BrennenJohnston/custom-braille-embosser-3d-printing-project/Documentation/_drafts/Reddit_Post_Copy.md

# Reddit Post - Custom Braille Embosser

> **Derived from:** [`Custom_Braille_Embosser_Publishing_Pack.md`](Custom_Braille_Embosser_Publishing_Pack.md). Edit the master pack first; re-derive this file.
> **Status:** This file mirrors the **most recent Reddit post copy** as written by the designer. Section B is the post body as intended for publishing.
> **Format:** Reddit self-post (a single Title field + a Markdown body). Paste the Title into the post title field and the Description into the post body. Good target subreddits include r/3Dprinting, r/functionalprint, r/Blind, and r/assistivetechnology (read each subreddit's self-promotion rules before posting).

---

## A. Title (paste into the Reddit post title field)

A surprisingly well functioning, fully 3D printed braille embosser for making custom braille business cards

---

## B. Description (paste into the Reddit post body)

I started this project last year because I wasn't able to find a quick, low cost way to make custom braille business cards. Custom business card braille embossers aren't easy to buy anymore, and the remaining options usually mean a slate and stylus, a Perkins style brailler, or a fully electric embosser (which is very expensive). Those tools all have their time and place, but none of them are simple or a cheap way to make a small batch of custom cards.

The device itself is pretty simple. It's fully 3D printed, hand operated, and snaps together from 10 parts with no fasteners, no springs, no glue, and no electronics. The braille message lives on a separate embossing cylinder paired with a matching counter cylinder. So, when the text changes, you only need to print a new embossing cylinder.

For the customizing part of the project, there is a browser based tool that handles the braille translation (powered by Liblouis) and generates both cylinder STLs for you. Your text and personal information never leaves your browser.

But if you just read that last sentence and said "NO THANK YOU!", that's completely fair. So there's also an OpenSCAD version included for anyone who prefers that workflow. The one tradeoff is that you'll need to grab your braille translation from a third party website and paste it into the OpenSCAD project yourself, which adds an extra step and is probably a steep learning curve if you haven't worked with OpenSCAD before.

The whole project is open source. My real hope is that others will develop this further than I'd ever have time to. There's lots of room for someone to refine the design or branch out into formats I never got around to, like full size pages, or different card sizes.

MakerWorld link: https://makerworld.com/en/models/2881581-custom-braille-card-embosser-hand-operated#profileId-3218374

Printables link: https://www.printables.com/model/1742352-custom-braille-embosser-a-hand-operated-3d-printab

Web-based braille customizer: https://braille-cylinder-stl-generator.vercel.app

I also made a 3 part video tutorial series covering the customizer, assembly, and usage if anyone wants to see it in action: https://youtu.be/77iXvJbkXh4?si=iJg1fes9QeOHQ45X

If you build one, I'd really appreciate a personal settings comment or review, so other makers know the design works on more printers. Thank you!
