BrennenJohnston/custom-braille-embosser-3d-printing-project/Photos/Custom Braille Embosser.png

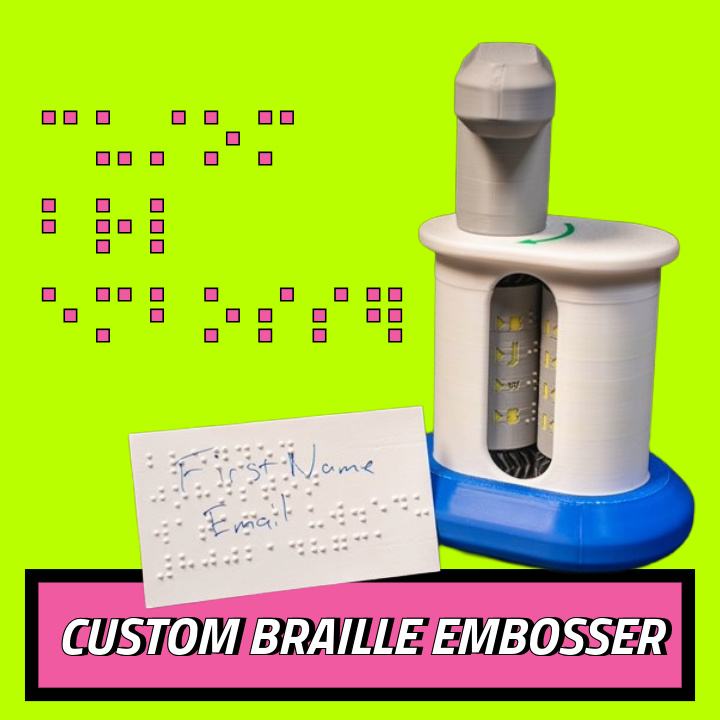
Photos/Custom Braille Embosser.png
