BrennenJohnston/custom-braille-embosser-3d-printing-project/Photos/DSC_8562.jpg

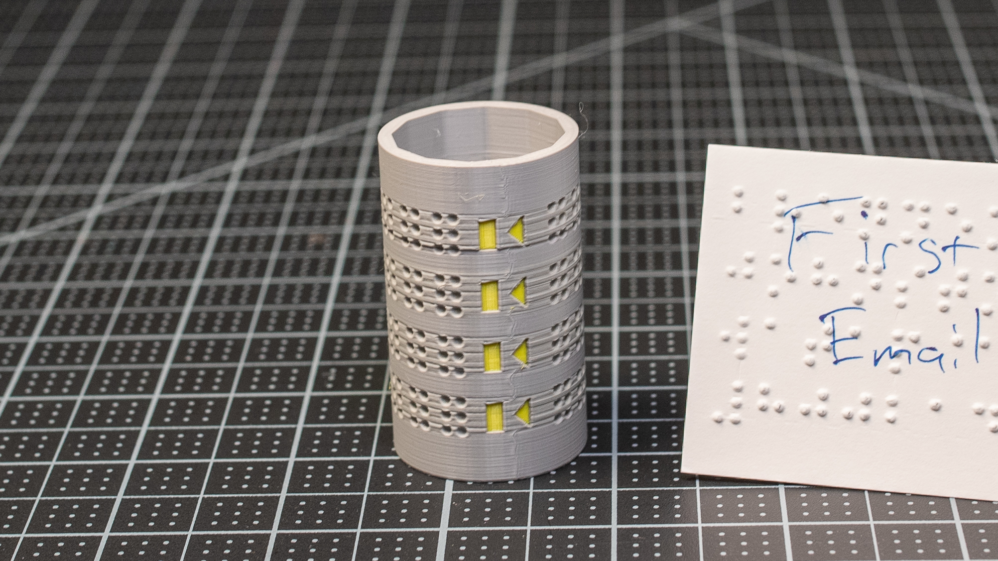
Photos/DSC_8562.jpg
