BrennenJohnston/custom-braille-embosser-3d-printing-project/Photos/DSC_8572.jpg

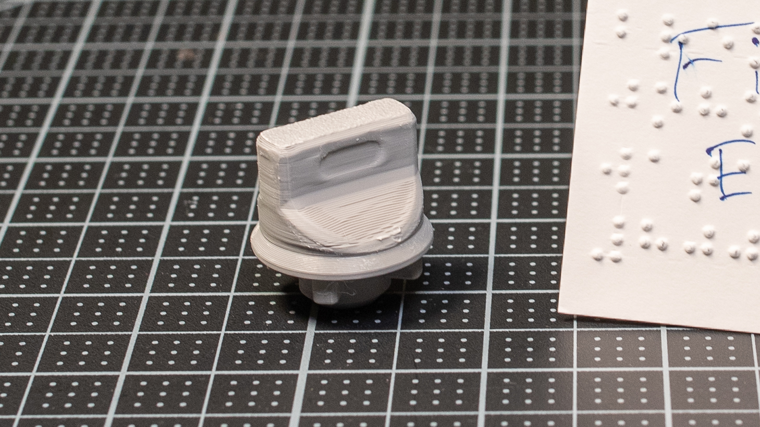
Photos/DSC_8572.jpg
