BrennenJohnston/custom-braille-embosser-3d-printing-project/Photos/DSC_8578.jpg

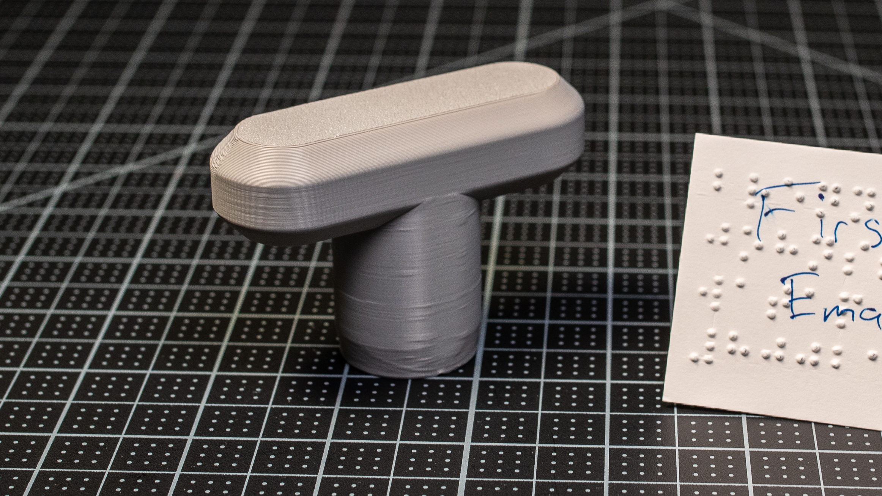
Photos/DSC_8578.jpg
