BrennenJohnston/custom-braille-embosser-3d-printing-project/Photos/DSC_8583.jpg

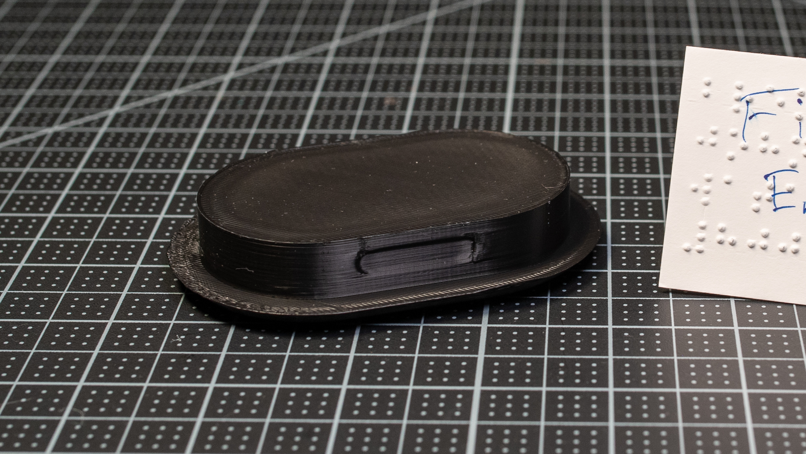
Photos/DSC_8583.jpg
