BrennenJohnston/custom-braille-embosser-3d-printing-project/Photos/DSC_8586-2.jpg

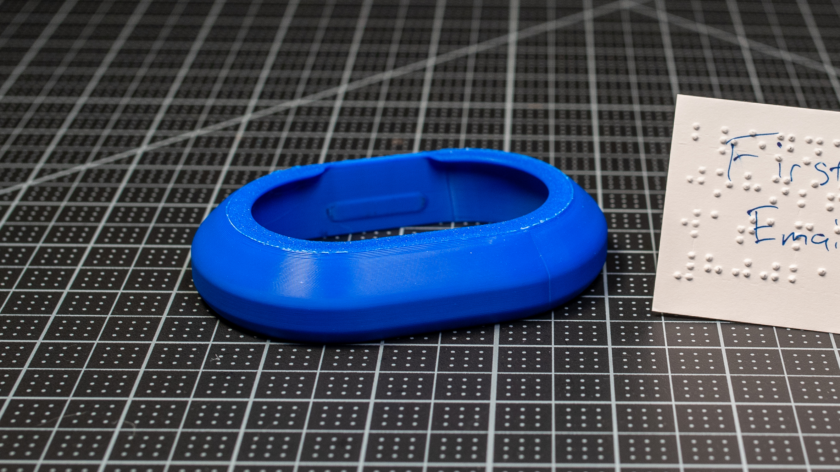
Photos/DSC_8586-2.jpg
