BrennenJohnston/custom-braille-embosser-3d-printing-project/Photos/Gif/Custom_Braille_Embosser_3d_Simulation.gif

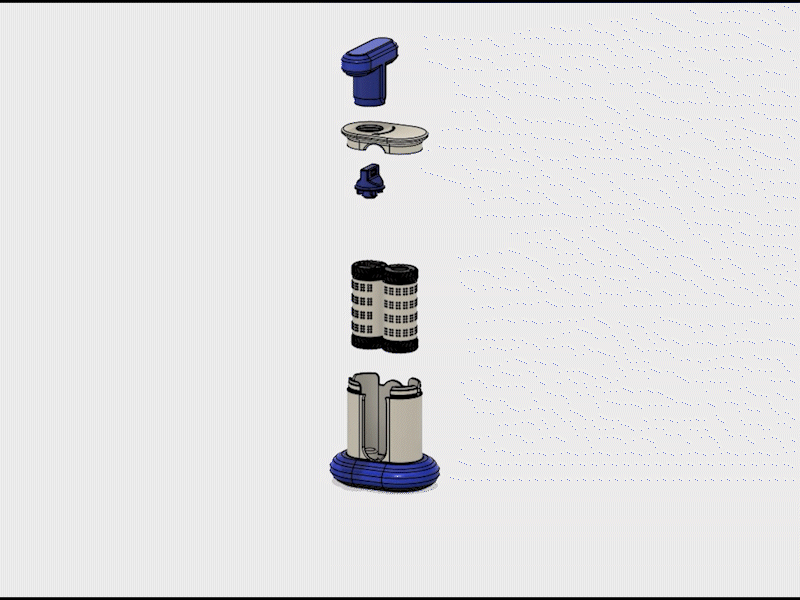
Photos/Gif/Custom_Braille_Embosser_3d_Simulation.gif
