BrennenJohnston/custom-braille-embosser-3d-printing-project/Settings Research/Cylinder High Quality profile/CHQP1.png

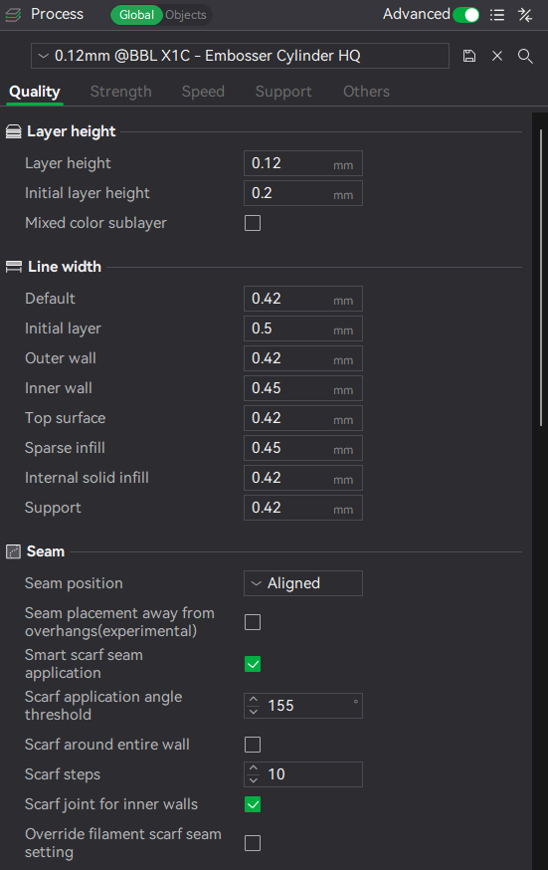
Settings Research/Cylinder High Quality profile/CHQP1.png
