BrennenJohnston/custom-braille-embosser-3d-printing-project/Settings Research/Cylinder High Quality profile/CHQP3.png

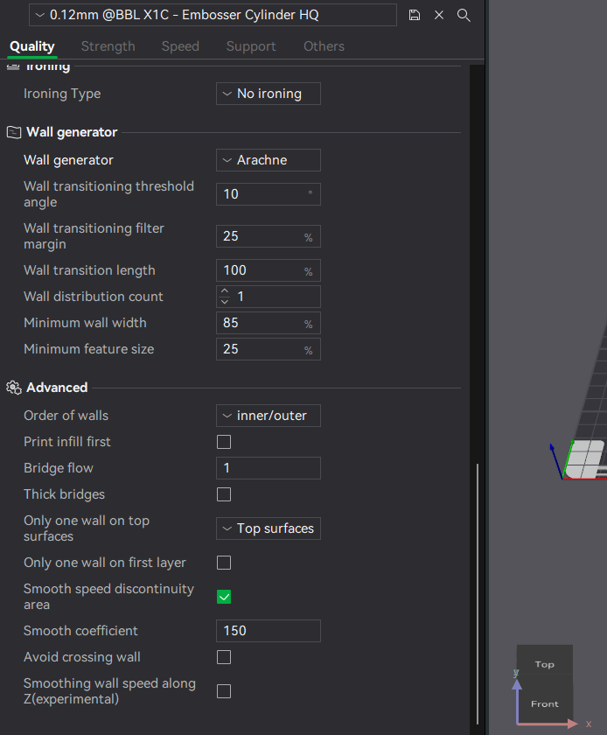
Settings Research/Cylinder High Quality profile/CHQP3.png
