BrennenJohnston/custom-braille-embosser-3d-printing-project/Settings Research/Cylinder High Quality profile/CHQP4.png

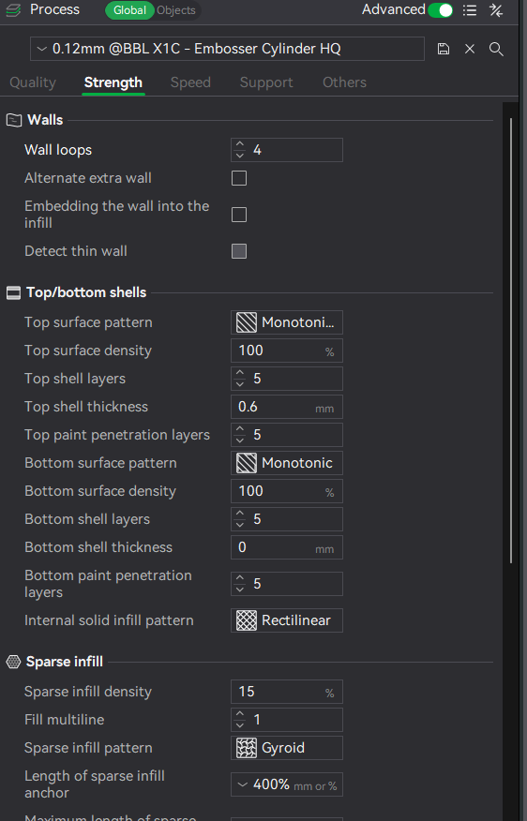
Settings Research/Cylinder High Quality profile/CHQP4.png
