BrennenJohnston/custom-braille-embosser-3d-printing-project/Settings Research/Cylinder High Quality profile/output.png

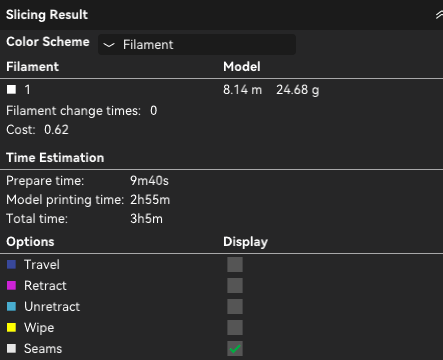
Settings Research/Cylinder High Quality profile/output.png
