BrennenJohnston/custom-braille-embosser-3d-printing-project/Build_Files/3D_Printing_Files/Print_Profiles/X1C/Braille Embosser Assembly and Custom Cylinders v1.0.3mf

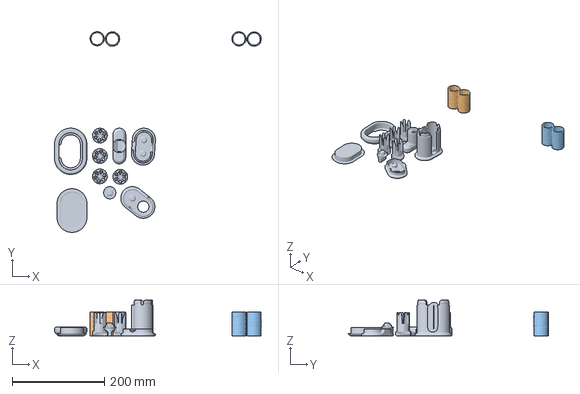
[picture p28: CAD file, 2026-07-27]
Build_Files/3D_Printing_Files/Print_Profiles/X1C/Braille Embosser Assembly and Custom Cylinders v1.0.3mf
448.9 x 435.4 x 77.6 mm
Assembly x 3
