BrennenJohnston/custom-braille-embosser-3d-printing-project/Build_Files/3D_Printing_Files/Print_Profiles/X1C/Braille Embosser Assembly v1.0 (0.2 Layer Height).3mf

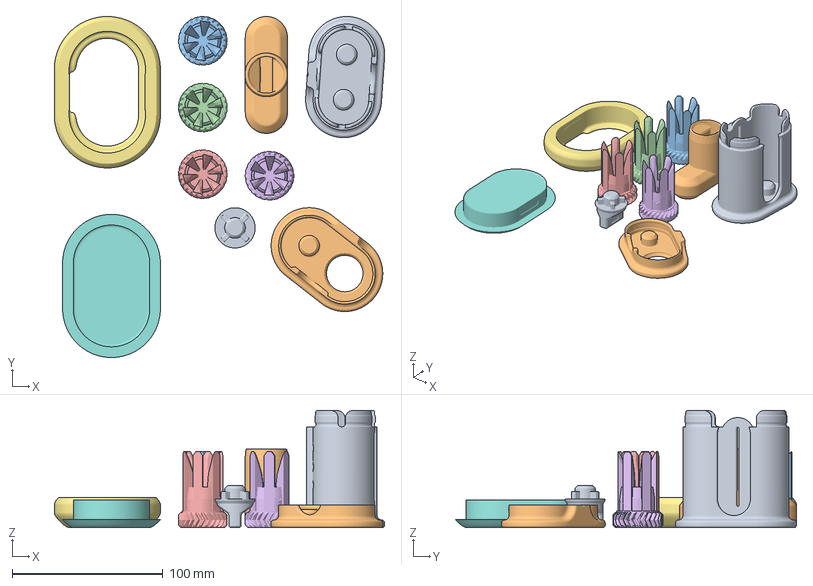
[picture p29: CAD file, 2026-07-27]
Build_Files/3D_Printing_Files/Print_Profiles/X1C/Braille Embosser Assembly v1.0 (0.2 Layer Height).3mf
219.0 x 226.0 x 77.6 mm
Base Body V6 (0.2) v12.stl
New Braille Roller Knob Handle V6 (0.2).stl
B2 v6 (0.2) v3.stl
B1 v6 (0.2) v3.stl
A2 v6 (0.2) v3.stl
A1 v6 (0.2) v3.stl
Braille Embosser Grip Bottom.stl
Braille Embosser Grip Top.stl
New Braille Roller Knob V6 (0.2).stl
Top Body V6 (0.2) v12.stl
