BrennenJohnston/custom-braille-embosser-3d-printing-project/Design_Files/CAD_Design_Files/STEP/P01-P10 - Braille Embosser Assembly v1.0.step

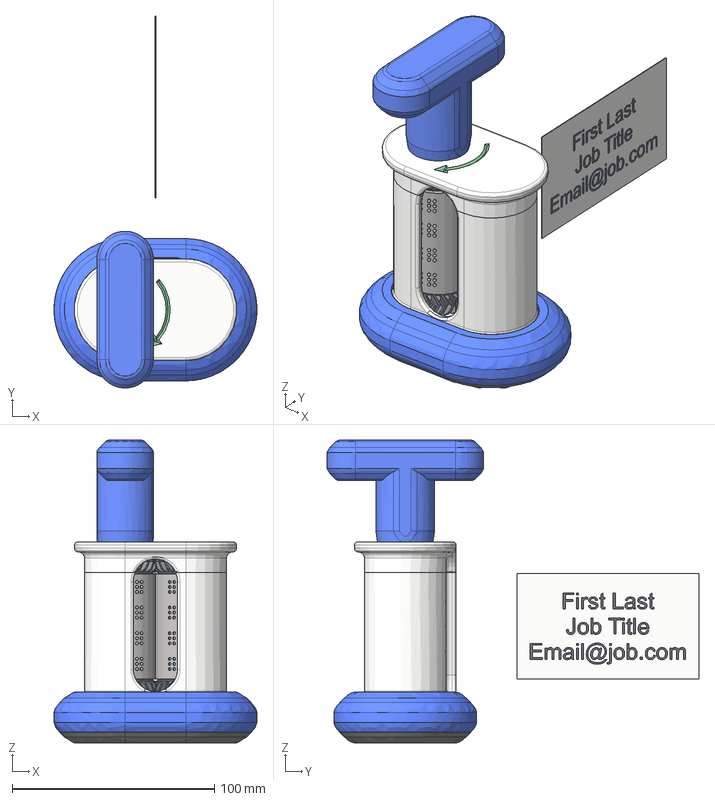
[picture p30: CAD file, 2026-07-27]
Design_Files/CAD_Design_Files/STEP/P01-P10 - Braille Embosser Assembly v1.0.step
100.3 x 183.8 x 149.6 mm
B2
B1
A2
A1
CP2
EP2
Top v6 (0.2)
Bottom v6 (0.2)
Knob
Handle
Bottom v6 (0.2)_1
Grip Top
Grip Bottom
Business Card Example
