BrennenJohnston/custom-braille-embosser-3d-printing-project/Build_Files/3D_Printing_Files/Embossing_Plates_Examples/Universal_Counter_Plate_0.3.stl

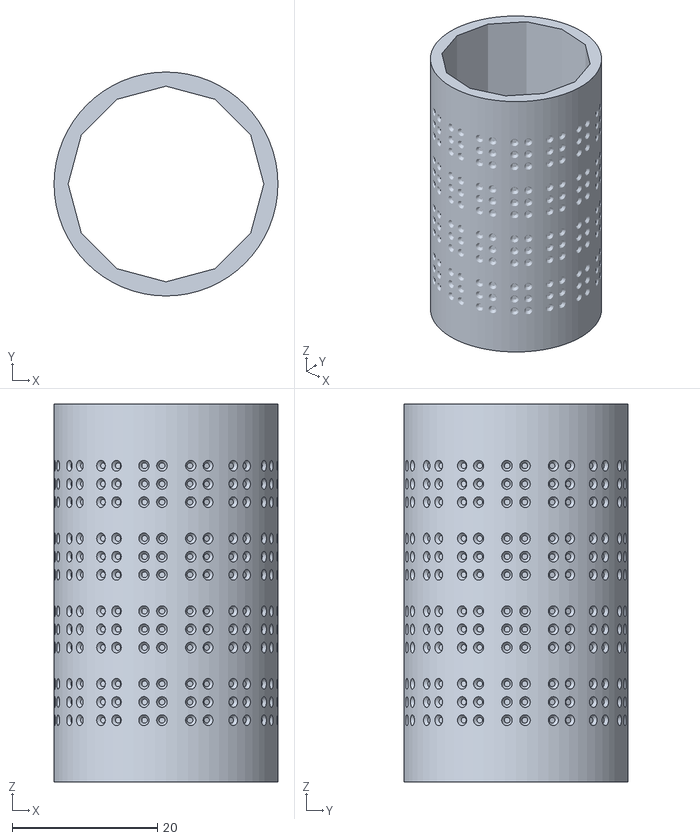
[picture p31: CAD file, 2026-07-27]
Build_Files/3D_Printing_Files/Embossing_Plates_Examples/Universal_Counter_Plate_0.3.stl
30.8 x 30.8 x 52.0
