BrennenJohnston/custom-braille-embosser-3d-printing-project/Build_Files/3D_Printing_Files/STL/P08 - Grip Extension Top v1.0 (0.2 Layer Height).stl

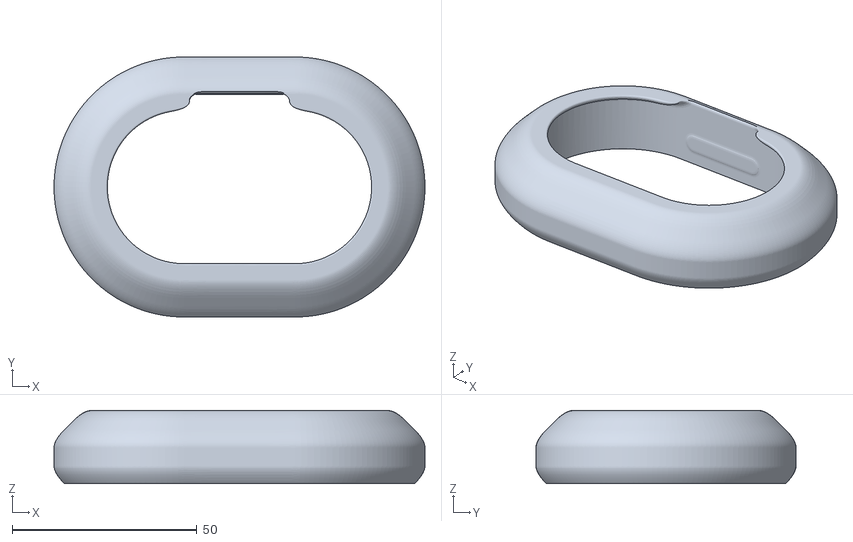
[picture p32: CAD file, 2026-07-27]
Build_Files/3D_Printing_Files/STL/P08 - Grip Extension Top v1.0 (0.2 Layer Height).stl
100.3 x 70.3 x 19.8
