BrennenJohnston/custom-braille-embosser-3d-printing-project/Design_Files/CAD_Design_Files/STEP/P09 Handle Connector + P10 Handle Grip - v1.0 (0.2 Layer Height).step

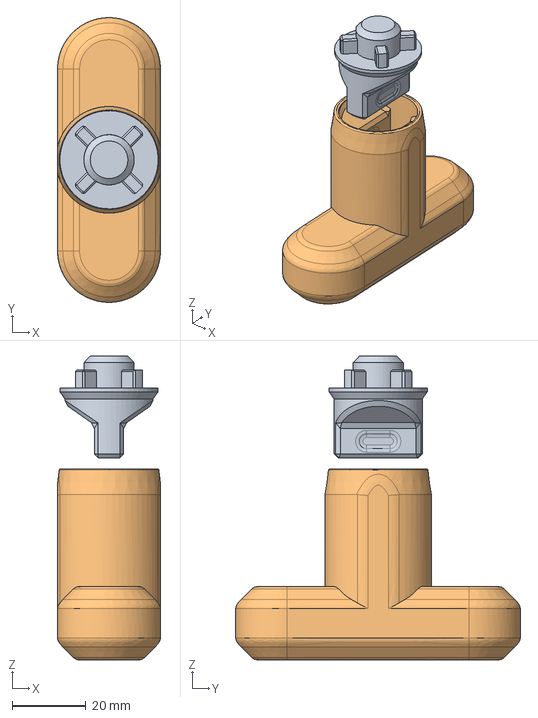
[picture p33: CAD file, 2026-07-27]
Design_Files/CAD_Design_Files/STEP/P09 Handle Connector + P10 Handle Grip - v1.0 (0.2 Layer Height).step
28.0 x 77.5 x 82.7 mm
Knob
Handle
