BrennenJohnston/custom-braille-embosser-3d-printing-project/Build_Files/3D_Printing_Files/Embossing_Plates_Examples/Embossing_Plate_Brennen_0.3.stl

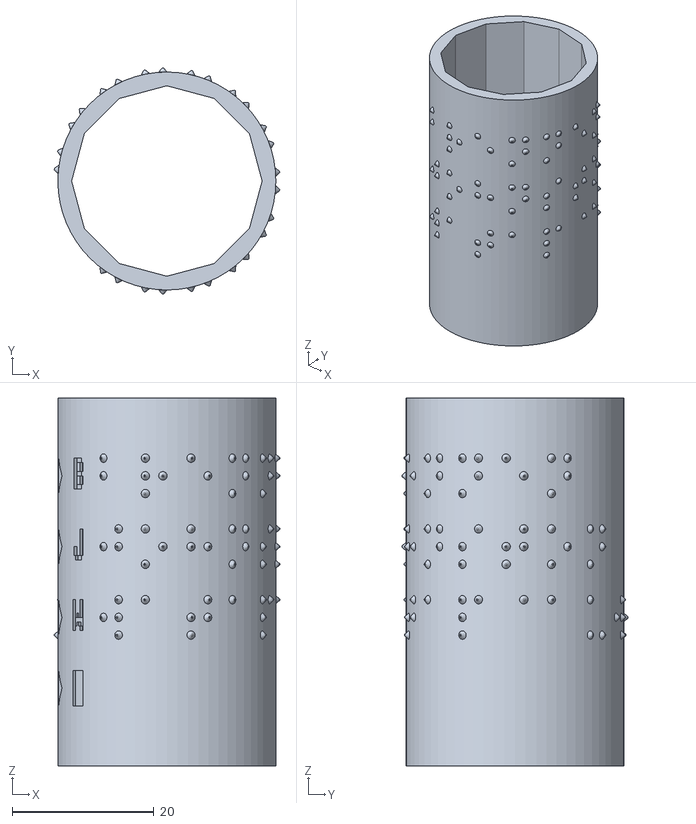
[picture p34: CAD file, 2026-07-27]
Build_Files/3D_Printing_Files/Embossing_Plates_Examples/Embossing_Plate_Brennen_0.3.stl
31.9 x 32.0 x 52.0
