BrennenJohnston/custom-braille-embosser-3d-printing-project/Build_Files/3D_Printing_Files/Print_Profiles/X1C/Embossing and Counter Cylinder High Quality.3mf

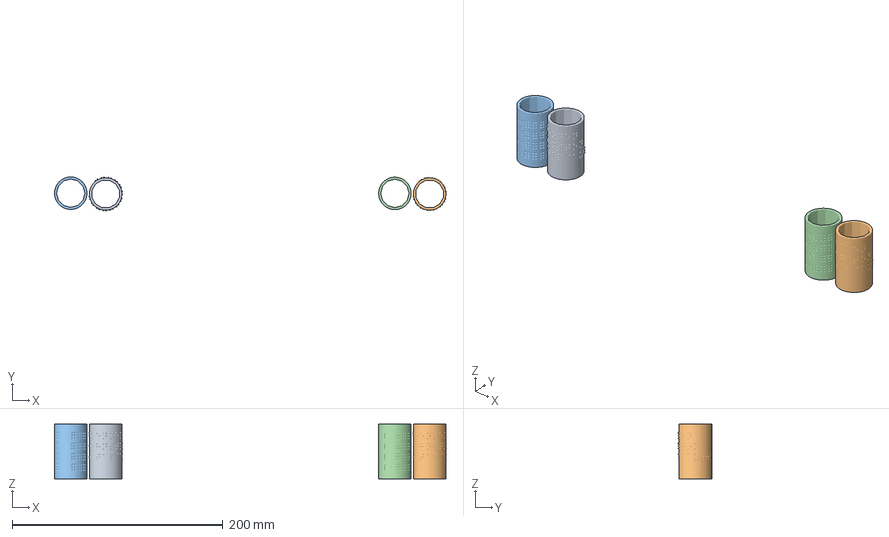
[picture p35: CAD file, 2026-07-27]
Build_Files/3D_Printing_Files/Print_Profiles/X1C/Embossing and Counter Cylinder High Quality.3mf
371.7 x 32.3 x 52.0 mm
Embossing_Plate_Brennen_0.4.stl
Embossing_Plate_Brennen_0.3.stl
Universal_Counter_Plate_0.4.stl
Universal_Counter_Plate_0.3.stl
