BrennenJohnston/custom-braille-embosser-3d-printing-project/Build_Files/3D_Printing_Files/STL/P01 - Body Base v1.0 (0.2 Layer Height).stl

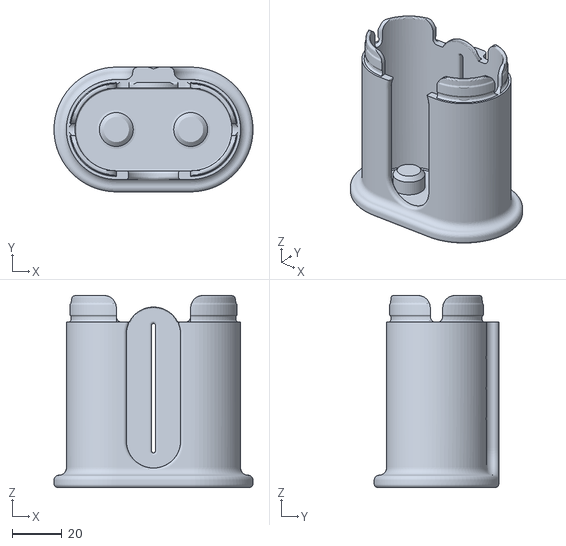
[picture p36: CAD file, 2026-07-27]
Build_Files/3D_Printing_Files/STL/P01 - Body Base v1.0 (0.2 Layer Height).stl
80.3 x 50.3 x 77.6
