BrennenJohnston/custom-braille-embosser-3d-printing-project/Design_Files/CAD_Design_Files/STEP/P03 Embosser Holder A1 + P04 Embosser Holder A2 + P05 Counter Holder B1 + P06 Counter Holder B2 - v1.0 (0.2 Layer Height).step

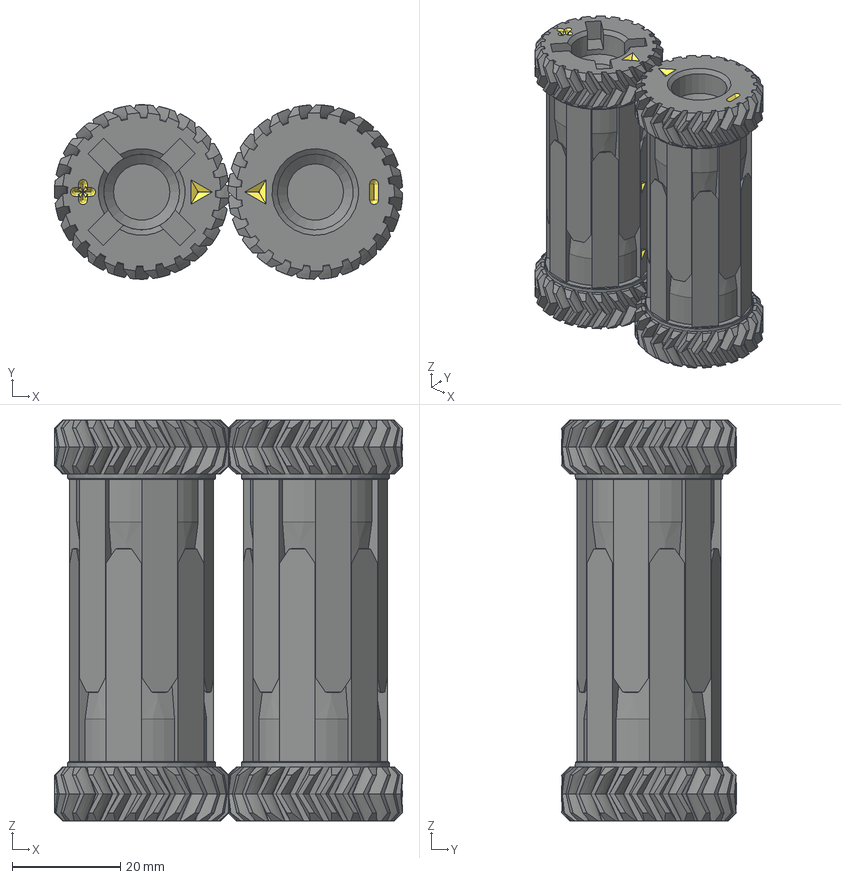
[picture p37: CAD file, 2026-07-27]
Design_Files/CAD_Design_Files/STEP/P03 Embosser Holder A1 + P04 Embosser Holder A2 + P05 Counter Holder B1 + P06 Counter Holder B2 - v1.0 (0.2 Layer Height).step
64.3 x 32.2 x 74.0 mm
B2
B1
A2
A1
