BrennenJohnston/custom-braille-embosser-3d-printing-project/Build_Files/3D_Printing_Files/STL/P02 - Body Top v1.0 (0.2 Layer Height).stl

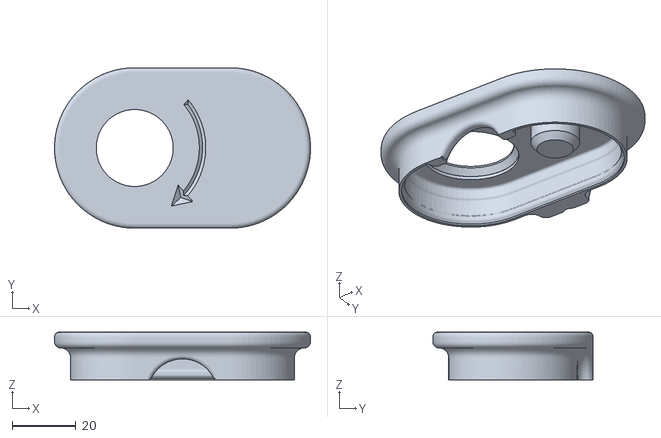
[picture p38: CAD file, 2026-07-27]
Build_Files/3D_Printing_Files/STL/P02 - Body Top v1.0 (0.2 Layer Height).stl
80.3 x 50.3 x 15.0
