BrennenJohnston/custom-braille-embosser-3d-printing-project/Design_Files/CAD_Design_Files/STEP/P07 Grip Extension Bottom + P08 Grip Extension Top - v1.0 (0.2 Layer Height).step

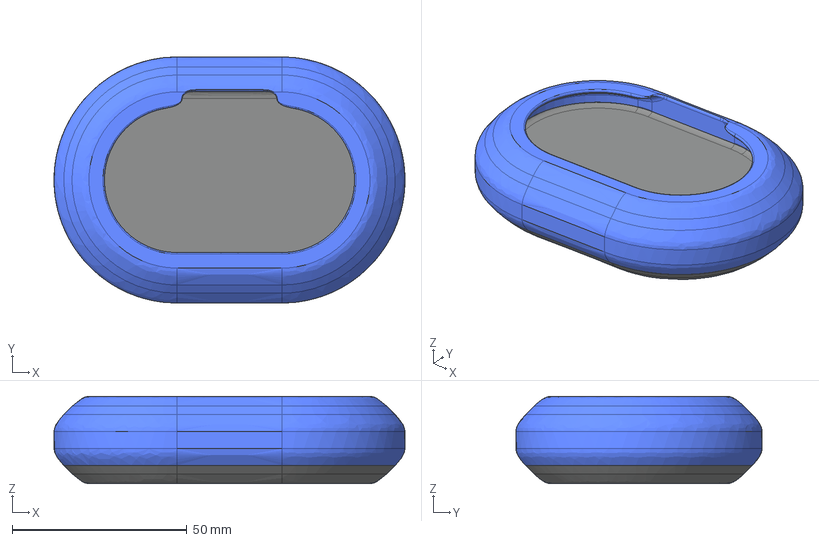
[picture p39: CAD file, 2026-07-27]
Design_Files/CAD_Design_Files/STEP/P07 Grip Extension Bottom + P08 Grip Extension Top - v1.0 (0.2 Layer Height).step
100.3 x 70.3 x 25.0 mm
Bottom v6 (0.2)
Grip Top
Grip Bottom
