BrennenJohnston/custom-braille-embosser-3d-printing-project/Design_Files/CAD_Design_Files/STEP/P01 Body Base + P02 Body Top - v1.0 (0.2 Layer Height).step

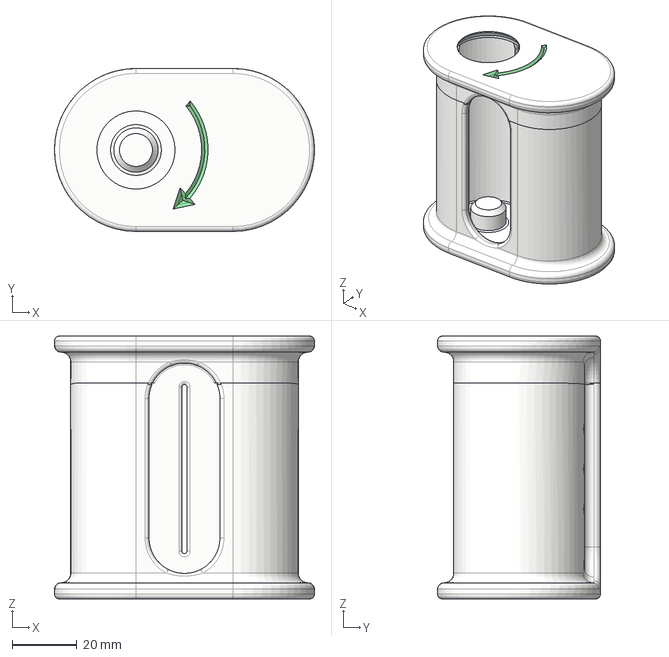
[picture p41: CAD file, 2026-07-27]
Design_Files/CAD_Design_Files/STEP/P01 Body Base + P02 Body Top - v1.0 (0.2 Layer Height).step
80.3 x 50.3 x 81.2 mm
Top v6 (0.2)
Bottom v6 (0.2)
