BrennenJohnston/custom-braille-embosser-3d-printing-project/Build_Files/3D_Printing_Files/STL/P09 - Handle Connector v1.0 (0.2 Layer Height).stl

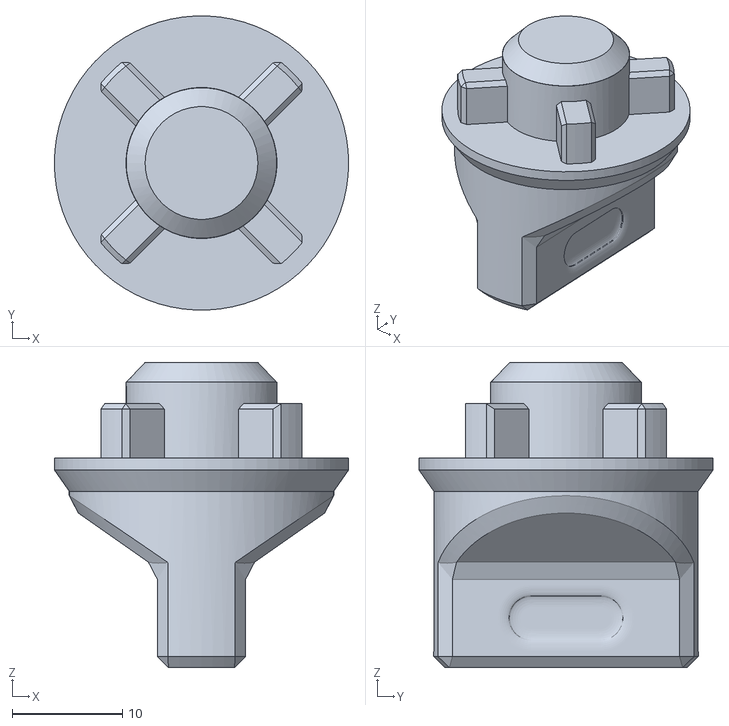
[picture p42: CAD file, 2026-07-27]
Build_Files/3D_Printing_Files/STL/P09 - Handle Connector v1.0 (0.2 Layer Height).stl
26.7 x 26.7 x 27.7
