BrennenJohnston/custom-braille-embosser-3d-printing-project/Build_Files/3D_Printing_Files/STL/P10 - Handle Grip v1.0 (0.2 Layer Height).stl

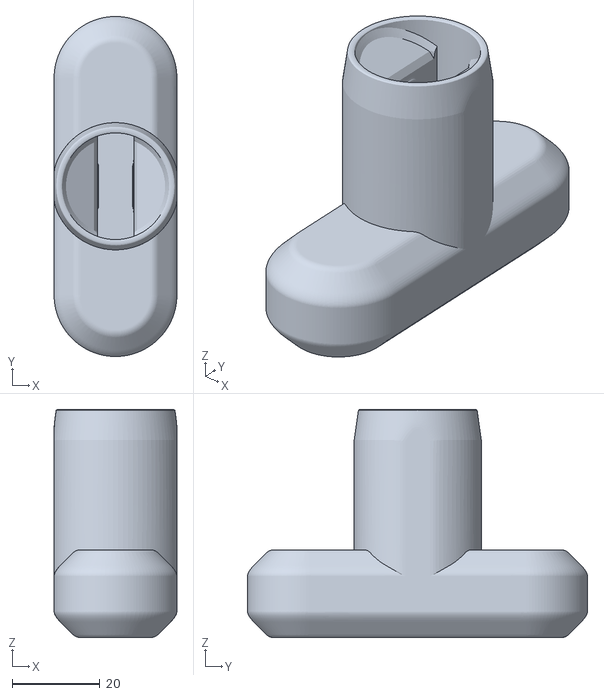
[picture p43: CAD file, 2026-07-27]
Build_Files/3D_Printing_Files/STL/P10 - Handle Grip v1.0 (0.2 Layer Height).stl
28.0 x 77.5 x 52.0
