BrennenJohnston/custom-braille-embosser-3d-printing-project/Build_Files/3D_Printing_Files/STL/P03 - Embosser Holder A1 v1.0 (0.2 Layer Height).stl

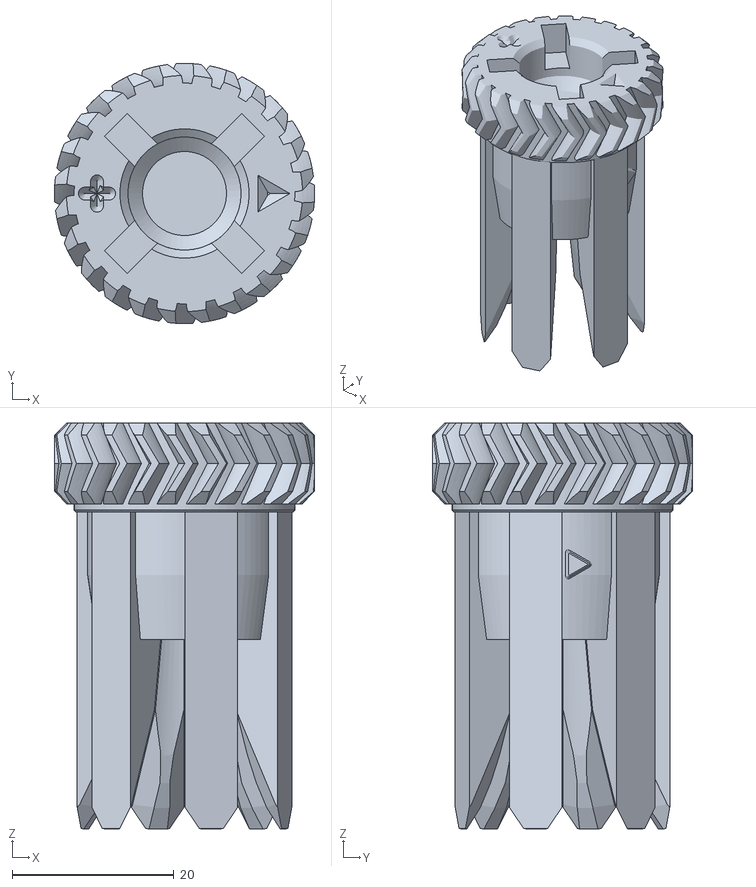
[picture p44: CAD file, 2026-07-27]
Build_Files/3D_Printing_Files/STL/P03 - Embosser Holder A1 v1.0 (0.2 Layer Height).stl
32.2 x 32.2 x 50.3
