BrennenJohnston/custom-braille-embosser-3d-printing-project/Build_Files/3D_Printing_Files/STL/P07 - Grip Extension Bottom v1.0 (0.2 Layer Height).stl

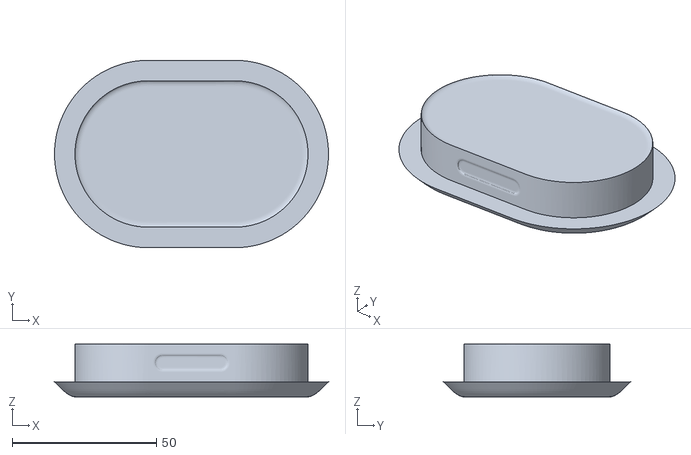
[picture p45: CAD file, 2026-07-27]
Build_Files/3D_Printing_Files/STL/P07 - Grip Extension Bottom v1.0 (0.2 Layer Height).stl
94.8 x 64.8 x 18.3
