BrennenJohnston/custom-braille-embosser-3d-printing-project/Build_Files/3D_Printing_Files/Embossing_Plates_Customizer/OpenSCAD_Offline_Alternative/Braille_Cylinder_STL_Generator.scad

// Braille Cylinder STL Generator (OpenSCAD)
// Generates embossing plates and counter plates for cylindrical objects
//
// =============================================================================
// WHAT THIS MAKES
// =============================================================================
//  • Cylinder Emboss Plate (Raised Dots) — dots on outer cylinder surface
//  • Cylinder Counter Plate (Hemispherical Recesses) — recesses on outer surface
//
// =============================================================================
// BEFORE YOU START
// =============================================================================
//  • Install OpenSCAD and open this .scad file
//  • In OpenSCAD, open View → Customizer to access all parameters
//  • This version requires pre-translated Unicode braille (no automatic translation)
//  • All parameters match the web-based generator UI for consistency
//
// =============================================================================
// TRANSLATE YOUR TEXT (REQUIRED) — BRANAH WORKFLOW
// =============================================================================
//  This OpenSCAD version does NOT include automatic translation. You must:
//  
//  1. Go to https://www.branah.com/braille-translator
//  2. In the options, select your desired braille grade:
//     - Grade 2 (contracted): Recommended for most uses
//     - Grade 1 (uncontracted): For names, emails, or when contractions cause confusion
//  3. Select Unicode Braille output (NOT ASCII Braille)
//  4. Type your English text in the left box
//  5. Copy the braille output (right box showing characters like ⠓⠑⠇⠇⠕)
//  6. In OpenSCAD's Customizer, paste into the Line_1, Line_2, etc. fields
//
//  IMPORTANT: If you paste ordinary English letters or see "INVALID CHARACTERS"
//  warning, re-translate on Branah and ensure Unicode Braille is selected.
//
// =============================================================================
// QUICK START GUIDE
// =============================================================================
//  1. Translate your text at https://www.branah.com/braille-translator
//  2. Paste pre-translated braille into Line_1, Line_2, etc.
//  3. Choose plate_type: Embossing Plate or Counter Plate
//  4. Choose dot_shape: Rounded or Cone (affects both plates)
//  5. Adjust dimensions in Expert Mode if needed
//  6. Render (F6) → File → Export → STL
//
// =============================================================================
// PARAMETER ORGANIZATION
// =============================================================================
//  Parameters are organized to match the web-based generator:
//
//  MAIN CONTROLS (always visible):
//  • Text Input - Pre-Translated Braille
//  • Plate Selection
//
//  EXPERT MODE (expandable submenus matching web UI):
//  • Expert Mode - Shape Selection (dot shapes, indicators)
//  • Expert Mode - Cylinder Dimensions
//  • Expert Mode - Braille Spacing (grid layout + positioning)
//  • Expert Mode - Braille Dot Adjustments (emboss/counter dimensions)
//
//  OPENSCAD-SPECIFIC:
//  • Rendering Quality
//
// =============================================================================
// REFERENCES
// =============================================================================
//  [1] Web-based Generator (with automatic translation): 
//      https://github.com/BrennenJohnston/braille-card-and-cylinder-stl-generator
//      https://braille-card-and-cylinder-stl-gener.vercel.app
//  [2] Branah Braille Translator: https://www.branah.com/braille-translator
//  [3] BANA — Size and Spacing: https://brailleauthority.org/size-and-spacing-braille-characters
//  [4] NLS — Specification 800: https://www.loc.gov/nls/
//  [5] 2010 ADA Standards: https://archive.ada.gov/
//
// =============================================================================
// ACKNOWLEDGMENTS
// =============================================================================
//  This OpenSCAD version is based on the web-based generator by Brennen Johnston.
//  Special thanks to Tobi Weinberg for the substantial time and effort volunteered
//  to help start the original project.
//
//  Original web app powered by Liblouis, an open-source professional braille
//  translator: https://liblouis.io/
// =============================================================================

/* [Text Input - Pre-Translated Braille] */
// Paste Unicode braille characters from https://www.branah.com/braille-translator
Line_1 = "⠓⠑⠇⠇⠕"; // First line of braille text
Line_2 = "⠺⠕⠗⠇⠙"; // Second line of braille text
Line_3 = ""; // Third line of braille text
Line_4 = ""; // Fourth line of braille text

/* [Plate Selection] */
// Choose which plate to generate
plate_type = "Embossing Plate"; // [Embossing Plate, Counter Plate]

/* [Paper Thickness Preset] */
// Preset optimized for paper thickness (sets multiple parameters below)
paper_thickness_preset = "0.4mm"; // [0.4mm, 0.3mm, Custom]

/* [Expert Mode - Shape Selection] */
// Braille Dot Shape (Emboss and Counter) - affects both plate types.
// PROJECT-LOCAL DEFAULT: "Cone" (upstream braille-stl-generator-openscad
// defaults to "Rounded"). Preserve this on re-vendor; see parent README
// "Project-local modifications" for rationale.
dot_shape = "Cone"; // [Rounded, Cone]
// Indicator Shapes (Emboss and Counter) - Row start/end markers
indicators = "On"; // [On, Off]

/* [Expert Mode - Cylinder Dimensions] */
cylinder_diameter_mm = 30.8; // [10:0.1:100] Cylinder outer diameter in mm
cylinder_height_mm = 52; // [20:1:150] Cylinder height in mm
polygon_cutout_radius_mm = 13.0; // [0:0.1:50] Polygonal cutout circumscribed radius (0 = no cutout)
polygon_cutout_points = 12; // [3:1:24] Number of sides/points for polygonal cutout
seam_offset_degrees = 0.0; // [0:1:360] Seam offset (degrees) — Rotates starting position around cylinder

/* [Expert Mode - Braille Spacing] */
// --- Braille Dimensions ---
grid_columns = 11; // [1:1:20] Number of braille cells per row available for text (2 cells reserved for indicators when On)
grid_rows = 4; // [1:1:10] Number of lines of braille
cell_spacing = 6.5; // [2:0.1:15] Horizontal spacing between cells (mm)
line_spacing = 10.0; // [5:0.1:25] Vertical spacing between lines (mm)
dot_spacing = 2.5; // [1:0.1:5] Spacing between dots within a cell (mm)

// --- Braille Positioning ---
// Note: on a cylinder, X = angular wrap around the seam — a linear "X adjust"
// has no useful meaning, so only the vertical adjust is exposed. Use
// `seam_offset_degrees` (Expert Mode - Cylinder Dimensions) to rotate the
// braille pattern around the cylinder axis.
braille_y_adjust = 0.0; // [-10:0.1:10] Vertical adjustment of braille pattern (mm)

/* [Expert Mode - Braille Dot Adjustments] */
// --- Embossing Braille Dot Dimensions (Rounded Shape) ---
rounded_dot_base_diameter = 1.5; // [0.5:0.1:3] Rounded dot base diameter (cone base) (mm)
rounded_dot_base_height = 0.5; // [0:0.1:2] Rounded dot base height (cone height) (mm)
rounded_dot_dome_diameter = 1.0; // [0.5:0.1:3] Rounded dome diameter (linked to cone flat top) (mm)
rounded_dot_dome_height = 0.5; // [0.1:0.1:2] Rounded dot dome height (mm)

// --- Embossing Braille Dot Dimensions (Cone Shape) ---
emboss_dot_base_diameter = 1.5; // [0.5:0.1:3] Cone dot base diameter (mm)
emboss_dot_height = 0.8; // [0.3:0.1:2] Cone dot height (mm)
emboss_dot_flat_hat = 0.4; // [0.1:0.1:2] Cone dot flat hat diameter (mm)

// --- Counter Braille Recessed Dot Dimensions (Rounded Shape / Bowl) ---
bowl_counter_dot_base_diameter = 1.8; // [0.5:0.1:5] Bowl recess base diameter (mm)
counter_dot_depth = 0.8; // [0.1:0.1:2] Bowl recess depth (mm)

// --- Counter Braille Recessed Dot Dimensions (Cone Shape) ---
cone_counter_dot_base_diameter = 1.9; // [0.5:0.1:3] Cone recess base diameter (mm)
cone_counter_dot_height = 0.7; // [0.3:0.1:2] Cone recess height (mm)
cone_counter_dot_flat_hat = 1.0; // [0.1:0.1:2] Cone recess flat hat diameter (mm)

/* [Rendering Quality] */
// Sphere quality for rounded shapes
render_quality = "Medium"; // [Low, Medium, High]
// Cone segments for cone shapes (8-32 range recommended)
cone_segments = 16; // [8:1:64] Number of segments for cone shapes

/* [Hidden] */
$fn = 32; // Resolution for curved surfaces

// Mathematical constants
PI = 3.14159265359;

// Preset value tables (PRESET_04, PRESET_03) and the preset_value() lookup
// helper live in presets.scad. Edit that file to change preset values.
include <presets.scad>;

// =============================================================================
// BACKWARD COMPATIBILITY - Test System Parameters
// =============================================================================
// The automated test system passes parameters via -D flags using these names.
// These hidden parameters allow the test system to work without modification.
//
// Usage: openscad -D 'combined_shape="rounded"' -D 'indicator_shapes="on"' ...
//
// IMPORTANT: keep this `/* [Hidden] */` marker so OpenSCAD's Customizer
// never renders these four vars as orphan, uncategorized sliders even if
// a new `/* [Section] */` heading gets inserted above this block later.
/* [Hidden] */
combined_shape = "";         // "rounded" or "cone" (from test system)
indicator_shapes = "";       // "on" or "off" (from test system)
hemisphere_quality = "";     // "low", "medium", "high" (from test system)
shape_type = "";             // "cylinder" (from test system, ignored - cylinder only)

// =============================================================================
// CALCULATED VALUES (Do not modify)
// =============================================================================

// Normalize dropdown selections to internal values
// Support both UI dropdowns (human-friendly) and test system parameters (lowercase)
is_emboss_plate = (plate_type == "positive") ? true :
                  (plate_type == "negative") ? false :
                  (plate_type == "Embossing Plate");

use_rounded_dots = (combined_shape == "rounded") ? true :
                   (combined_shape == "cone") ? false :
                   (dot_shape == "Rounded");

indicator_on = (indicator_shapes == "on") ? true :
               (indicator_shapes == "off") ? false :
               (indicators == "On");

// Map render quality to segment counts (support both UI and test system)
quality_fn = (hemisphere_quality == "low" || render_quality == "Low") ? 24 :
             (hemisphere_quality == "medium" || render_quality == "Medium") ? 32 :
             (hemisphere_quality == "high" || render_quality == "High") ? 64 : 32;

// =============================================================================
// PRESET ROUTING - Select preset vs. custom values
// =============================================================================
// Each `_preset_*` variable routes between the matching preset table entry
// (see presets.scad) and the user's slider value. If `paper_thickness_preset`
// is "0.4mm" or "0.3mm", the table value wins; otherwise the slider value
// (third argument) is used.

// Spacing parameters
_preset_grid_columns                   = preset_value(paper_thickness_preset, "grid_columns",                   grid_columns);
_preset_grid_rows                      = preset_value(paper_thickness_preset, "grid_rows",                      grid_rows);
_preset_cell_spacing                   = preset_value(paper_thickness_preset, "cell_spacing",                   cell_spacing);
_preset_line_spacing                   = preset_value(paper_thickness_preset, "line_spacing",                   line_spacing);
_preset_dot_spacing                    = preset_value(paper_thickness_preset, "dot_spacing",                    dot_spacing);
_preset_braille_y_adjust               = preset_value(paper_thickness_preset, "braille_y_adjust",               braille_y_adjust);

// Emboss Rounded parameters
_preset_rounded_dot_base_diameter      = preset_value(paper_thickness_preset, "rounded_dot_base_diameter",      rounded_dot_base_diameter);
_preset_rounded_dot_base_height        = preset_value(paper_thickness_preset, "rounded_dot_base_height",        rounded_dot_base_height);
_preset_rounded_dot_dome_diameter      = preset_value(paper_thickness_preset, "rounded_dot_dome_diameter",      rounded_dot_dome_diameter);
_preset_rounded_dot_dome_height        = preset_value(paper_thickness_preset, "rounded_dot_dome_height",        rounded_dot_dome_height);

// Emboss Cone parameters
_preset_emboss_dot_base_diameter       = preset_value(paper_thickness_preset, "emboss_dot_base_diameter",       emboss_dot_base_diameter);
_preset_emboss_dot_height              = preset_value(paper_thickness_preset, "emboss_dot_height",              emboss_dot_height);
_preset_emboss_dot_flat_hat            = preset_value(paper_thickness_preset, "emboss_dot_flat_hat",            emboss_dot_flat_hat);

// Counter Bowl parameters
_preset_bowl_counter_dot_base_diameter = preset_value(paper_thickness_preset, "bowl_counter_dot_base_diameter", bowl_counter_dot_base_diameter);
_preset_counter_dot_depth              = preset_value(paper_thickness_preset, "counter_dot_depth",              counter_dot_depth);

// Counter Cone parameters
_preset_cone_counter_dot_base_diameter = preset_value(paper_thickness_preset, "cone_counter_dot_base_diameter", cone_counter_dot_base_diameter);
_preset_cone_counter_dot_height        = preset_value(paper_thickness_preset, "cone_counter_dot_height",        cone_counter_dot_height);
_preset_cone_counter_dot_flat_hat      = preset_value(paper_thickness_preset, "cone_counter_dot_flat_hat",      cone_counter_dot_flat_hat);

// Cylinder parameters
_preset_cylinder_diameter_mm           = preset_value(paper_thickness_preset, "cylinder_diameter_mm",           cylinder_diameter_mm);
_preset_cylinder_height_mm             = preset_value(paper_thickness_preset, "cylinder_height_mm",             cylinder_height_mm);
_preset_polygon_cutout_radius_mm       = preset_value(paper_thickness_preset, "polygon_cutout_radius_mm",       polygon_cutout_radius_mm);
_preset_polygon_cutout_points          = preset_value(paper_thickness_preset, "polygon_cutout_points",          polygon_cutout_points);
_preset_seam_offset_degrees            = preset_value(paper_thickness_preset, "seam_offset_degrees",            seam_offset_degrees);

// =============================================================================
// ACTIVE PARAMETERS - Final values used by geometry
// =============================================================================
// These variables provide the final parameter values used by the geometry code.
// They incorporate both preset routing (above) and shape-based routing (rounded vs cone).

// Active emboss dot parameters (based on shape selection, using preset-routed values)
// Note: cone/rounded emboss modules consume the underlying _preset_* constants
// directly; only the composite height is needed at this layer.
active_emboss_height = use_rounded_dots ? (_preset_rounded_dot_base_height + _preset_rounded_dot_dome_height) : _preset_emboss_dot_height;

// Active counter dot parameters (based on shape selection, using preset-routed values)
active_counter_base_diameter = use_rounded_dots ? _preset_bowl_counter_dot_base_diameter : _preset_cone_counter_dot_base_diameter;
active_counter_height = use_rounded_dots ? _preset_counter_dot_depth : _preset_cone_counter_dot_height;

// Active spacing parameters (pass through from preset routing)
active_grid_columns = _preset_grid_columns;
active_grid_rows = _preset_grid_rows;
active_cell_spacing = _preset_cell_spacing;
active_line_spacing = _preset_line_spacing;
active_dot_spacing = _preset_dot_spacing;
active_braille_y_adjust = _preset_braille_y_adjust;

// Active cylinder parameters (pass through from preset routing)
active_cylinder_diameter_mm = _preset_cylinder_diameter_mm;
active_cylinder_height_mm = _preset_cylinder_height_mm;
active_polygon_cutout_radius_mm = _preset_polygon_cutout_radius_mm;
active_polygon_cutout_points = _preset_polygon_cutout_points;
active_seam_offset_degrees = _preset_seam_offset_degrees;

// Grid dimensions (accounting for indicator shapes if enabled)
actual_grid_columns = indicator_on ? (active_grid_columns + 2) : active_grid_columns;
grid_width = (actual_grid_columns - 1) * active_cell_spacing;
grid_height = (active_grid_rows - 1) * active_line_spacing;
top_margin = (active_cylinder_height_mm - grid_height) / 2;

// Cylinder grid geometry — shared by cylinder_emboss_plate and
// cylinder_counter_plate. Both modules used to recompute these identically
// inline; hoisting them keeps the two plates in lockstep so any spacing
// change automatically applies to both. Names mirror the prior local names
// so the module bodies need no changes beyond removing the duplicates.
radius                = active_cylinder_diameter_mm / 2;
grid_angle            = grid_width / radius;
start_angle           = -grid_angle / 2;
cell_spacing_angle    = active_cell_spacing / radius;
dot_spacing_angle     = active_dot_spacing / radius;
dot_col_angle_offsets = [-dot_spacing_angle / 2, dot_spacing_angle / 2];
dot_row_offsets       = [active_dot_spacing, 0, -active_dot_spacing];
dot_positions         = [[0, 0], [1, 0], [2, 0], [0, 1], [1, 1], [2, 1]];

// Counter plate recess radii (spherical cap formula to match web generator)
// For a bowl recess: R = (a² + h²) / (2h) where a = opening radius, h = depth
// This ensures the opening diameter = bowl_counter_dot_base_diameter and depth = counter_dot_depth
_bowl_a = _preset_bowl_counter_dot_base_diameter / 2;
_bowl_h = _preset_counter_dot_depth;
bowl_recess_radius = (_bowl_a * _bowl_a + _bowl_h * _bowl_h) / (2 * _bowl_h);
bowl_center_offset = bowl_recess_radius - _bowl_h;

// =============================================================================
// HELPER FUNCTIONS
// =============================================================================

// Check if a character is valid Unicode braille (U+2800 to U+28FF)
function is_braille_char(c) = (c >= 10240 && c <= 10495);

// Check if string contains invalid characters
function has_invalid_chars(str) = 
    len(str) == 0 ? false : 
    len([for (i = [0:len(str)-1]) if (!is_braille_char(ord(str[i]))) i]) > 0;

// Get the 6-dot pattern from a Unicode braille character
function get_dot_pattern(char) =
    let(code = ord(char))
    (code >= 10240 && code <= 10495) ?
        let(pattern = code - 10240)
        [
            (pattern % 2) >= 1 ? 1 : 0,              // Dot 1
            floor(pattern / 2) % 2 >= 1 ? 1 : 0,     // Dot 2
            floor(pattern / 4) % 2 >= 1 ? 1 : 0,     // Dot 3
            floor(pattern / 8) % 2 >= 1 ? 1 : 0,     // Dot 4
            floor(pattern / 16) % 2 >= 1 ? 1 : 0,    // Dot 5
            floor(pattern / 32) % 2 >= 1 ? 1 : 0     // Dot 6
        ]
    : [0,0,0,0,0,0]; // Empty pattern for non-braille

// =============================================================================
// $fn TESSELLATION POLICY
// =============================================================================
//
// Every curved-surface primitive below picks its $fn from exactly one source
// based on what kind of surface it is. The five sources are intentionally
// segregated (not competing) — pick whichever matches your geometry class:
//
//   1. CYLINDER_SHELL_FN = 64   — the outer cylinder shell. Hardcoded so the
//      visual roundness of the printable face matches the web preview's
//      three.js mesh exactly. Fixture STLs depend on this; never make it
//      user-tweakable.
//
//   2. cone_segments  (slider)  — every cone/frustum primitive (emboss dot
//      base/sides, cone counter recess). User-controllable 8..64; default 16.
//      Cones are the cheapest primitive, so a low default keeps render time
//      low while still allowing the user to crank it up for final exports.
//
//   3. quality_fn  (derived)    — every SPHERE primitive (the rounded dome
//      on top of an emboss dot, and the spherical-cap bowl counter recess).
//      Spheres cost O(n²) facets so we route them through a 3-step quality
//      dropdown: Low/24, Medium/32, High/64. The hemisphere_quality test
//      override also flows in here for cross-platform fixtures.
//
//   4. active_polygon_cutout_points (slider)  — the optional polygonal
//      cutout subtracted from the cylinder shell. $fn here is SEMANTIC: it
//      directly controls how many sides the cutout has (e.g. 6 for a hex
//      hole), so the value is the cutout's purpose, not its quality.
//
//   5. global $fn = 32 (default) — anything not in cases 1–4 (mainly 2D
//      shapes inside linear_extrude, where curvature isn't expressed).
//
// If you add a new curved primitive, pick the case that matches and pass
// its constant explicitly. Do not rely on the global $fn for any visible
// curved surface or you will silently desync from the web preview.
//
// =============================================================================
// INDICATOR SHAPE MODULES
// =============================================================================
//
// Reference: braille-card-and-cylinder-stl-generator/docs/specifications/
//   RECESS_INDICATOR_SPECIFICATIONS.md
//
// CRITICAL SEMANTICS:
// - Indicators are ALWAYS RECESSED (subtracted) for BOTH emboss and counter plates.
// - Cylinder layout (when indicators ON):
//     Column 0: Triangle marker (counter plate triangle rotated 180°)
//     Column 1: Rectangle placeholder (counter ALWAYS rectangle; emboss uses rect for braille input)
//
INDICATOR_TRIANGLE_DEPTH_EMBOSS = 0.6;
INDICATOR_RECT_DEPTH_EMBOSS     = 0.5;

// Radial epsilon pushed into the cylinder shell so recessed indicator
// markers and cone-counter recesses break coplanar boolean faces cleanly
// (without this, CGAL/Manifold can produce zero-area facets at the contact
// patch and STL exporters complain about non-manifold edges).
INDICATOR_OVERCUT = 0.05;

// Cylinder shell tessellation count. The cylinder is rendered as a regular
// prism; 64 segments gives near-cylindrical appearance at modest cost.
// Keep in sync with the web preview's three.js shell segments.
CYLINDER_SHELL_FN = 64;

// "INVALID CHARACTERS" warning text placement (rendered above the cylinder
// when get_dot_pattern() returns the bad-pattern marker for an untranslated
// English glyph).
INVALID_TEXT_Z_OFFSET   = 5;   // mm above the cylinder top
INVALID_TEXT_SIZE       = 5;   // text() font size in mm
INVALID_TEXT_DEPTH      = 2;   // linear_extrude height in mm
INVALID_TEXT_STACK_GAP  = 8;   // mm gap above INVALID CHARACTERS to stack TEXT TOO LONG

module indicator_triangle_2d(rotate_180 = false) {
    // Isosceles triangle with vertical base on LEFT, apex RIGHT (default).
    // When rotate_180=true, triangle is rotated 180° about its center.
    polygon(points = rotate_180 ?
        [
            [+active_dot_spacing/2, +active_dot_spacing],
            [+active_dot_spacing/2, -active_dot_spacing],
            [-active_dot_spacing/2, 0]
        ] :
        [
            [-active_dot_spacing/2, -active_dot_spacing],
            [-active_dot_spacing/2, +active_dot_spacing],
            [+active_dot_spacing/2, 0]
        ]
    );
}

module indicator_rectangle_2d() {
    // Rectangle is NOT centered on the cell center; it is centered at (x + dot_spacing/2, y).
    translate([active_dot_spacing/2, 0])
        square([active_dot_spacing, 2 * active_dot_spacing], center = true);
}

module indicator_triangle_prism_centered(depth, rotate_180 = false) {
    translate([0, 0, -depth/2])
        linear_extrude(height = depth)
            indicator_triangle_2d(rotate_180 = rotate_180);
}

module indicator_rectangle_prism_centered(depth) {
    translate([0, 0, -depth/2])
        linear_extrude(height = depth)
            indicator_rectangle_2d();
}

// Cylinder marker placement helper
module place_cylinder_marker(theta_deg, y_pos, cyl_radius, depth, overcut = INDICATOR_OVERCUT) {
    radial_offset = cyl_radius - depth/2 + overcut;
    x = radial_offset * cos(theta_deg);
    y = radial_offset * sin(theta_deg);
    translate([x, y, y_pos])
        rotate([90, 0, theta_deg - 90])
            children();
}

// =============================================================================
// DOT CREATION MODULES
// =============================================================================

// Create an embossing braille dot CENTERED at origin for CYLINDER surface
// Geometry spans from -totalHeight/2 to +totalHeight/2 along Z axis
module braille_dot_centered() {
    _total_height = use_rounded_dots ? 
                    (_preset_rounded_dot_base_height + _preset_rounded_dot_dome_height) : 
                    _preset_emboss_dot_height;
    
    if (use_rounded_dots) {
        // Spherical cap formula: R = (r² + h²) / (2h)
        _dome_r = _preset_rounded_dot_dome_diameter / 2;
        _R_sphere = (_dome_r * _dome_r + _preset_rounded_dot_dome_height * _preset_rounded_dot_dome_height) / (2 * _preset_rounded_dot_dome_height);
        _center_z = _preset_rounded_dot_base_height + _preset_rounded_dot_dome_height - _R_sphere;
        
        // Center the combined geometry at Z=0
        translate([0, 0, -_total_height / 2]) {
            union() {
                // Frustum base
                translate([0, 0, _preset_rounded_dot_base_height / 2])
                cylinder(
                    h = _preset_rounded_dot_base_height,
                    r1 = _preset_rounded_dot_base_diameter / 2,
                    r2 = _preset_rounded_dot_dome_diameter / 2,
                    center = true,
                    $fn = cone_segments
                );
                // Dome: proper spherical cap
                intersection() {
                    translate([0, 0, _center_z])
                    sphere(r = _R_sphere, $fn = quality_fn);
                    translate([0, 0, _preset_rounded_dot_base_height + _R_sphere])
                    cube([_R_sphere * 4, _R_sphere * 4, _R_sphere * 2], center = true);
                }
            }
        }
    } else {
        // Cone frustum - already centered
        cylinder(
            h = _preset_emboss_dot_height,
            r1 = _preset_emboss_dot_base_diameter / 2,
            r2 = _preset_emboss_dot_flat_hat / 2,
            center = true,
            $fn = cone_segments
        );
    }
}

// Create a recess for counter plate (bowl or cone shape)
module counter_recess() {
    if (use_rounded_dots) {
        // Bowl recess (spherical cap)
        translate([0, 0, bowl_center_offset])
        sphere(r = bowl_recess_radius, $fn = quality_fn);
    } else {
        // Cone frustum recess
        translate([0, 0, -_preset_cone_counter_dot_height / 2])
        cylinder(
            h = _preset_cone_counter_dot_height,
            r1 = _preset_cone_counter_dot_flat_hat / 2,
            r2 = _preset_cone_counter_dot_base_diameter / 2,
            center = true,
            $fn = cone_segments
        );
    }
}

// =============================================================================
// CYLINDER MODULES
// =============================================================================

module cylinder_shell(cutout_rotate_deg = 0) {
    difference() {
        // Outer cylinder (see $fn TESSELLATION POLICY: case 1)
        cylinder(h = active_cylinder_height_mm, r = active_cylinder_diameter_mm / 2, center = true, $fn = CYLINDER_SHELL_FN);
        
        // Polygonal cutout if specified
        if (active_polygon_cutout_radius_mm > 0) {
            // Web UI: "Circumscribed Radius" but implementation uses inscribed radius
            cutout_circumradius = active_polygon_cutout_radius_mm / cos(180 / active_polygon_cutout_points);
            rotate([0, 0, cutout_rotate_deg])
                cylinder(h = active_cylinder_height_mm + 2, r = cutout_circumradius, $fn = active_polygon_cutout_points, center = true);
        }
    }
}

module cylinder_emboss_plate() {
    translate([0, 0, active_cylinder_height_mm/2]) {
        // Angular grid + dot-positioning constants are derived at top level;
        // see `radius`, `start_angle`, `dot_positions`, etc. above.
        difference() {
            union() {
                // Base cylinder
                cylinder_shell(cutout_rotate_deg = -active_seam_offset_degrees);

                // Check for invalid characters
                invalid_found = has_invalid_chars(Line_1) || has_invalid_chars(Line_2) ||
                               has_invalid_chars(Line_3) || has_invalid_chars(Line_4);
                
                if (invalid_found) {
                    translate([0, 0, active_cylinder_height_mm/2 + INVALID_TEXT_Z_OFFSET])
                    color("red")
                    linear_extrude(height = INVALID_TEXT_DEPTH)
                    text("INVALID CHARACTERS", size = INVALID_TEXT_SIZE, halign = "center", valign = "center");
                }

                // Check whether any line exceeds the cells available for text.
                // When indicators are on, the first two cells are reserved for
                // alignment markers, so usable capacity drops by 2.
                text_too_long =
                    max([len(Line_1), len(Line_2), len(Line_3), len(Line_4)])
                    > (active_grid_columns - (indicator_on ? 2 : 0));

                if (text_too_long) {
                    translate([0, 0, active_cylinder_height_mm/2 + INVALID_TEXT_Z_OFFSET + INVALID_TEXT_STACK_GAP])
                    color("red")
                    linear_extrude(height = INVALID_TEXT_DEPTH)
                    text("TEXT TOO LONG", size = INVALID_TEXT_SIZE, halign = "center", valign = "center");
                }
        
                // Create braille dots on cylinder surface
                lines = [Line_1, Line_2, Line_3, Line_4];
                
                for (row = [0 : min(active_grid_rows - 1, len(lines) - 1)]) {
                    if (len(lines[row]) > 0) {
                        y_pos = active_cylinder_height_mm/2 - top_margin - (row * active_line_spacing) + active_braille_y_adjust;
                        
                        for (col = [0 : min(active_grid_columns - 1, len(lines[row]) - 1)]) {
                            actual_col = indicator_on ? (col + 2) : col;
                            angle_rad = start_angle + (actual_col * cell_spacing_angle);
                            angle_deg = angle_rad * 180 / PI;
                            dots = get_dot_pattern(lines[row][col]);
                            
                            for (i = [0:5]) {
                                if (dots[i] == 1) {
                                    dot_pos = dot_positions[i];
                                    dot_angle_rad = angle_rad + dot_col_angle_offsets[dot_pos[1]];
                                    dot_angle_deg = dot_angle_rad * 180 / PI;
                                    dot_y = y_pos + dot_row_offsets[dot_pos[0]];
                                    
                                    x = (radius + active_emboss_height/2) * cos(dot_angle_deg);
                                    y = (radius + active_emboss_height/2) * sin(dot_angle_deg);
                                    
                                    translate([x, y, dot_y])
                                        rotate([0, 90, dot_angle_deg])
                                            braille_dot_centered();
                                }
                            }
                        }
                    }
                }
            }

            // Subtract indicator recesses if enabled
            if (indicator_on) {
                for (row = [0 : active_grid_rows - 1]) {
                    y_pos = active_cylinder_height_mm/2 - top_margin - (row * active_line_spacing) + active_braille_y_adjust;

                    // Column 0: Triangle marker (apex RIGHT)
                    tri_theta_deg = start_angle * 180 / PI;
                    place_cylinder_marker(tri_theta_deg, y_pos, radius, INDICATOR_TRIANGLE_DEPTH_EMBOSS)
                        indicator_triangle_prism_centered(INDICATOR_TRIANGLE_DEPTH_EMBOSS, rotate_180 = false);

                    // Column 1: Rectangle marker
                    rect_theta_deg = (start_angle + cell_spacing_angle) * 180 / PI;
                    place_cylinder_marker(rect_theta_deg, y_pos, radius, INDICATOR_RECT_DEPTH_EMBOSS)
                        indicator_rectangle_prism_centered(INDICATOR_RECT_DEPTH_EMBOSS);
                }
            }
        }
    }
}

module cylinder_counter_plate() {
    translate([0, 0, active_cylinder_height_mm/2])
    difference() {
        // Base cylinder
        cylinder_shell(cutout_rotate_deg = active_seam_offset_degrees);

        // Angular grid + dot-positioning constants are derived at top level;
        // see `radius`, `start_angle`, `dot_positions`, etc. above.

        // Create indicator recesses if enabled
        if (indicator_on) {
            for (row = [0 : active_grid_rows - 1]) {
                y_pos = active_cylinder_height_mm/2 - top_margin - (row * active_line_spacing) + active_braille_y_adjust;

                // Column 0: Triangle marker (ROTATED 180° on counter plate)
                tri_theta_deg = -(start_angle * 180 / PI);
                place_cylinder_marker(tri_theta_deg, y_pos, radius, active_counter_height)
                    indicator_triangle_prism_centered(active_counter_height, rotate_180 = true);

                // Column 1: Rectangle placeholder (ALWAYS rectangle on counter plates)
                rect_theta_deg = -((start_angle + cell_spacing_angle) * 180 / PI);
                place_cylinder_marker(rect_theta_deg, y_pos, radius, active_counter_height)
                    indicator_rectangle_prism_centered(active_counter_height);
            }
        }
        
        // Create recesses for ALL possible dot positions
        for (row = [0 : active_grid_rows - 1]) {
            y_pos = active_cylinder_height_mm/2 - top_margin - (row * active_line_spacing) + active_braille_y_adjust;
            
            for (col = [0 : active_grid_columns - 1]) {
                actual_col = indicator_on ? (col + 2) : col;
                angle_rad = start_angle + (actual_col * cell_spacing_angle);
                angle_deg = -(angle_rad * 180 / PI);
                
                for (i = [0:5]) {
                    dot_pos = dot_positions[i];
                    dot_angle_rad = angle_rad + dot_col_angle_offsets[dot_pos[1]];
                    dot_angle_deg = -(dot_angle_rad * 180 / PI);
                    dot_y = y_pos + dot_row_offsets[dot_pos[0]];
                    
                    recess_radius_offset = use_rounded_dots ? 0 : INDICATOR_OVERCUT;
                    x = (radius + recess_radius_offset) * cos(dot_angle_deg);
                    y = (radius + recess_radius_offset) * sin(dot_angle_deg);
                    
                    translate([x, y, dot_y])
                    rotate([0, 90, dot_angle_deg])
                    counter_recess();
                }
            }
        }
    }
}

// =============================================================================
// MAIN RENDERING
// =============================================================================

if (is_emboss_plate) {
    cylinder_emboss_plate();
} else {
    cylinder_counter_plate();
}

// End of file
