BrennenJohnston/custom-braille-embosser-3d-printing-project/(list of files, cad)

Other CAD files:
Build_Files/3D_Printing_Files/Embossing_Plates_Examples/Embossing_Plate_Brennen_0.4.stl
Build_Files/3D_Printing_Files/Embossing_Plates_Examples/Universal_Counter_Plate_0.4.stl
Build_Files/3D_Printing_Files/STL/P05 - Counter Holder B1 v1.0 (0.2 Layer Height).stl
Build_Files/3D_Printing_Files/STL/P04 - Embosser Holder A2 v1.0 (0.2 Layer Height).stl
Build_Files/3D_Printing_Files/Embossing_Plates_Customizer/OpenSCAD_Offline_Alternative/MakerWorld_Upload/Braille_Cylinder_STL_Generator.scad
Design_Files/CAD_Design_Files/Fusion/Braille Embosser Assembly v1.0.f3z
