BrennenJohnston/custom-braille-embosser-3d-printing-project/Documentation/_drafts/Custom_Braille_Embosser_User_Guide.md

# Custom Braille Embosser - User Guide

> **Document version:** 1.0 | 2026-May-31
> **Designer:** Brennen Johnston
> **For:** end users of the assembled Custom Braille Embosser

---

## 1. Introduction

The **Custom Braille Embosser** is a small, hand-operated device that imprints permanent, raised, Grade-1 or Grade-2 braille onto card stock. You squeeze the handle, and a sheet of card is rolled between two cylindrical plates - an *embossing plate* with raised dots and a *universal counter plate* with matching cavities. The dots are pressed into the card permanently.

The plates are interchangeable: a different cylindrical pair gives you a different braille message. New plates are generated by entering text into one of the companion programs (see Section 4: Compatibility).

This guide is for **users of an already-built and already-assembled** embosser. If you are *building* one from scratch, refer to the Maker Guide.

For a transcript-backed written walkthrough of the three tutorial videos, see `Video_Tutorials/Custom_Braille_Embosser_Written_Tutorial.md`.

## 2. Labelled Features

Refer to **Photos/Custom_Braille_Embosser.jpg** and the labelled diagrams in the assembly and use video tutorials. The device has the following user-facing features:

> **Video walkthrough of how to use the completed embosser:** <https://youtu.be/77iXvJbkXh4> (Video 3 - "How to use completed Braille Embosser"). Local mirror: `Video_Tutorials/Video_3_How_To_Use_Completed_Braille_Embosser/`.

| Label | Feature | What it does |
|---|---|---|
| A | **Body Base (lower body)** | Holds the embossing plate (the one with raised dots) inside the Embosser Holder pair. |
| B | **Body Top (upper body)** | Holds the universal counter plate (the one with cavities) inside the Counter Holder pair. |
| C | **Card-stock slot** | The horizontal gap between the two plates where you insert the card. |
| D | **Grip Extension (Bottom + Top)** | Extends the body forward into a comfortable squeeze-grip for the user. |
| E | **Handle Connector + Handle Grip** | The user-side lever you squeeze to roll the plates and emboss the card. |
| F | **Indicator triangles** | Alignment marks that show the cylinder start position and the direction the braille will emboss. |

> **TODO for the user:** replace this section with a labelled photograph (or diagram) of the assembled device. The MMC Template Guide (page 27) recommends one labelled image per major user-facing feature.

## 3. Specifications

| Specification | Value |
|---|---|
| Total mass (10 printed parts) | **268.81 g** as sliced for the included Bambu Lab X1C profile with PLA Basic (258.79 g model + 10.02 g support); actual finished mass varies slightly with filament and supports |
| Overall dimensions (L x W x H) | TBD - take a measurement on your assembled unit (Fusion 360 source: `Design_Files/CAD_Design_Files/Fusion/Braille Embosser Assembly v1.0.f3z`) |
| Operating force | Hand-squeezable; no specific minimum measured. Comfortable for adult users. |
| Supported card-stock thickness | **0.3 mm** (~110-130 lb / ~250-300 gsm) and **0.4 mm** (~150 lb / ~350 gsm) |
| Supported card sheet sizes | Any sheet up to A4 / Letter that fits between the plates; embossing area equals the active cylinder length (typically 60-100 mm). |
| Power | None - manual operation only |
| Maintenance | None other than wiping plates with a soft cloth |
| Material (3D-printed parts) | PLA or PETG, 0.2 mm layer height |
| Service life | Indefinite when used as designed; replace any part by reprinting its STL |

## 4. Compatibility

The Custom Braille Embosser is **plate-driven**: the device itself does not contain any text. Each braille message is encoded in its own pair of 3D-printed cylindrical plates:

- **Embossing plate** (raised dots) - sits inside the Embosser Holder A1/A2 pair in the Body Base.
- **Universal counter plate** (matching cavities) - sits inside the Counter Holder B1/B2 pair in the Body Top.

### 4.1 How to get more plates (two customizer options)

Two officially supported customizer options are available. **For most users, use the web-based customizer (primary).** The OpenSCAD version is an alternative for users who want to work offline or have full parametric control.

| Customizer | Use case | Where to find it |
|---|---|---|
| **Primary - Web-Based** | Most users; auto-translates English to Grade 1 / Grade 2 braille (50+ languages); works on any browser, including screen-reader users; no install. | <https://braille-cylinder-stl-generator.vercel.app> |
| **Alternative - OpenSCAD (offline)** | Offline use; full parametric control; existing OpenSCAD/CAD workflows. Included locally in this repo at [`Build_Files/3D_Printing_Files/Embossing_Plates_Customizer/OpenSCAD_Offline_Alternative/`](../../Build_Files/3D_Printing_Files/Embossing_Plates_Customizer/OpenSCAD_Offline_Alternative). Requires manual translation via <https://www.branah.com/braille-translator>. | OpenSCAD 2024.x or newer |

A side-by-side comparison of the two is kept up to date in [`Build_Files/3D_Printing_Files/Embossing_Plates_Customizer/README.md`](../../Build_Files/3D_Printing_Files/Embossing_Plates_Customizer/README.md). The detailed workflow for each is in **Section 7** of the [Maker Guide](Custom_Braille_Embosser_Maker_Guide.md).

### 4.2 Pre-generated example plates

Two pre-generated example pairs are included in `Build_Files/3D_Printing_Files/Embossing_Plates_Examples/`:
- `Embossing_Plate_Brennen_0.3.stl` + `Universal_Counter_Plate_0.3.stl` - for 0.3 mm card stock.
- `Embossing_Plate_Brennen_0.4.stl` + `Universal_Counter_Plate_0.4.stl` - for 0.4 mm card stock.

These are useful for confirming the embosser is built correctly before generating user-specific plates.

### 4.3 Card-stock matching - critical

> **Important:** the embossing plate and the counter plate must match the card-stock thickness you intend to use. Using a 0.3 mm counter plate with 0.4 mm card will produce shallow, ill-formed dots; using a 0.4 mm counter plate with 0.3 mm card may not produce dots at all.

> **Useful shortcut from the transcript:** when the braille text changes but the card thickness stays the same, you usually only need a new embossing plate. The universal counter plate can be reused for other messages at that same thickness.

## 5. How to Use

### 5.1 Set the start position
1. Turn the handle until the **indicator triangles on both cylinders are directly on top of each other**.
2. This is the starting position shown in Video 3.
3. Rotate the entire embosser so the rollers are **horizontal** before inserting the card.

### 5.2 Orient the card correctly
1. Use the indicator triangles as your guide. They point in the direction the braille will be embossed.
2. Orient the card so it rolls **from left to right**, with the printed information **facing up** in the direction the triangles point.
3. Lower or drop the card gently into the slot between the rollers.
4. Double-check that the card looks level before you emboss.

### 5.3 Emboss the card
1. Rotate the handle **forward about a half turn**.
2. If you want to inspect the braille while it is forming, you can flip the embosser partway through and look at the dots.
3. If needed, move the handle back and forth slightly to finish the dots, but **stop before going past the last dot**. Going too far can misalign the embossing.
4. Once the dots look correct, roll the card all the way through.

### 5.4 Remove and read the card
1. Pull the card out.
2. Run your fingers across the embossed area to confirm the dots are readable.
3. If the dots are too shallow, check that the cylinder pair matches the card thickness:
   - **0.4 mm** cylinders for standard business-card stock
   - **0.3 mm** cylinders for thinner card stock

### 5.5 Swap cylinder pairs when you want a different message
1. Pull the lid off the embosser. The handle can stay attached.
2. Remove the current cylinders and insert the replacement embossing / counter pair.
3. If a fresh cylinder pair is stuck in the base, carefully work it loose with a **small flathead screwdriver**.
4. Re-align the indicator triangles before embossing the next card.

## 6. Cleaning

- Wipe both plates with a **dry, soft cloth** to remove paper dust between sessions.
- For stubborn marks, use a cloth lightly dampened with isopropyl alcohol. Do **not** soak PLA or PETG parts.
- Avoid solvents such as acetone (will damage PLA-based parts).

## 7. Care

- Store the embosser at room temperature, out of direct sunlight (PLA softens above ~50 °C).
- Do not drop the device onto hard floors; the snap-fit joints can pop apart on impact (they can be re-snapped, but repeated impacts may stress the joints).
- Re-print and replace any cracked or worn part using the STL files in `Build_Files/3D_Printing_Files/STL/`.

## 8. Disposal

- All 3D-printed parts are PLA or PETG and can be **recycled with #7 (other) plastics** where municipal recycling accepts that stream, or sent to a filament-recycling service.
- The device contains no batteries, no electronics, no metal fasteners, no glue. There are no hazardous materials.
