BrennenJohnston/custom-braille-embosser-3d-printing-project/Build_Files/3D_Printing_Files/Embossing_Plates_Customizer/OpenSCAD_Offline_Alternative/docs/PARAMETER_MAPPING.md

# OpenSCAD to Web App Parameter Mapping

This document maps the OpenSCAD customizer parameters to the web-based braille generator UI controls.

**Note:** This repository contains only the OpenSCAD cylinder generator. For the web app source code, see [braille-card-and-cylinder-stl-generator](https://github.com/BrennenJohnston/braille-card-and-cylinder-stl-generator). This mapping ensures the OpenSCAD Customizer stays aligned with web UI terminology and defaults.

## Overview

The OpenSCAD version has been updated to match the web-based generator's UI parameters. The only differences are:
1. OpenSCAD requires **pre-translated Unicode braille** characters (no automatic translation)
2. OpenSCAD is **cylinder-only** (card support removed)

## Translation Workflow

1. **Web App**: Automatic translation using Liblouis (Grade 1 or Grade 2)
2. **OpenSCAD**: Manual translation required at https://www.branah.com/braille-translator
   - User must select Grade 1 or Grade 2 manually
   - Copy Unicode braille output
   - Paste into OpenSCAD Line_1, Line_2, etc.

## Parameter Mapping

### Text Input - Pre-Translated Braille
| OpenSCAD Parameter | Web App Equivalent | Notes |
|---|---|---|
| `Line_1` | Line 1 text input | Must be pre-translated Unicode braille |
| `Line_2` | Line 2 text input | Must be pre-translated Unicode braille |
| `Line_3` | Line 3 text input | Must be pre-translated Unicode braille |
| `Line_4` | Line 4 text input | Must be pre-translated Unicode braille |

### Plate Selection
| OpenSCAD Parameter | Web App Equivalent | Values |
|---|---|---|
| `plate_type` | Select Plate to Generate | `"Embossing Plate"`, `"Counter Plate"` |

### Paper Thickness Preset
| OpenSCAD Parameter | Web App Equivalent | Default | Values |
|---|---|---|---|
| `paper_thickness_preset` | Card Thickness | `"0.4mm"` | `"0.4mm"`, `"0.3mm"`, `"Custom"` |

**Note:** The web UI label is "Card Thickness" but this is NOT the removed card-geometry feature. This is a parametric memory system that automatically sets 23 parameters (spacing, dot dimensions, and cylinder settings) to known-good values optimized for different paper thicknesses. Selecting "0.4mm" or "0.3mm" forces all preset-controlled parameters to specific values. "Custom" indicates that values deviate from presets.

### Expert Mode - Shape Selection
| OpenSCAD Parameter | Web App Equivalent | Values |
|---|---|---|
| `dot_shape` | Braille Dot Shape | `"Rounded"`, `"Cone"` |
| `indicators` | Indicator Shapes | `"On"`, `"Off"` |

### Expert Mode - Cylinder Dimensions
| OpenSCAD Parameter | Web App Equivalent | Default | Range |
|---|---|---|---|
| `cylinder_diameter_mm` | Diameter | 30.8 mm | 10-100 mm |
| `cylinder_height_mm` | Height | 52 mm | 20-150 mm |
| `polygon_cutout_radius_mm` | Cutout Radius | 13.0 mm | 0-50 mm |
| `polygon_cutout_points` | Cutout Points/Sides | 12 | 3-24 |
| `seam_offset_degrees` | Seam Offset | 0.0° | 0-360° |

### Expert Mode - Braille Spacing
| OpenSCAD Parameter | Web App Equivalent | Default | Range |
|---|---|---|---|
| `grid_columns` | Number of Braille Cells | 11 | 1-20 |
| `grid_rows` | Number of Braille Lines | 4 | 1-10 |
| `cell_spacing` | Braille Cell Spacing | 6.5 mm | 2-15 mm |
| `line_spacing` | Braille Line Spacing | 10.0 mm | 5-25 mm |
| `dot_spacing` | Braille Dot Spacing | 2.5 mm | 1-5 mm |

### Expert Mode - Braille Positioning
| OpenSCAD Parameter | Web App Equivalent | Default | Range |
|---|---|---|---|
| `braille_y_adjust` | Y Adjust | 0.0 mm | -10 to 10 mm |

> Removed in v2.2.0: `braille_x_adjust`. On a cylinder the X axis is the angular
> wrap around the seam, so a linear "X adjust" had no useful meaning. Use
> `seam_offset_degrees` (Cylinder Dimensions) for angular pattern offset.

### Expert Mode - Emboss Dot Dimensions (Rounded Shape)
| OpenSCAD Parameter | Web App Equivalent | Default | Range |
|---|---|---|---|
| `rounded_dot_base_diameter` | Rounded dot base diameter (cone base) | 1.5 mm | 0.5-3 mm |
| `rounded_dot_base_height` | Rounded dot base height (cone height) | 0.5 mm | 0-2 mm |
| `rounded_dot_dome_diameter` | Rounded dome diameter | 1.0 mm | 0.5-3 mm |
| `rounded_dot_dome_height` | Rounded dot dome height | 0.5 mm | 0.1-2 mm |

### Expert Mode - Emboss Dot Dimensions (Cone Shape)
| OpenSCAD Parameter | Web App Equivalent | Default | Range |
|---|---|---|---|
| `emboss_dot_base_diameter` | Dot diameter | 1.5 mm | 0.5-3 mm |
| `emboss_dot_height` | Dot height | 0.8 mm | 0.3-2 mm |
| `emboss_dot_flat_hat` | Flat hat diameter | 0.4 mm | 0.1-2 mm |

### Expert Mode - Counter Dot Dimensions (Rounded Shape / Bowl)
| OpenSCAD Parameter | Web App Equivalent | Default | Range |
|---|---|---|---|
| `bowl_counter_dot_base_diameter` | Bowl Recess Dot Base Diameter | 1.8 mm | 0.5-5 mm |
| `counter_dot_depth` | Bowl Recess Depth | 0.8 mm | 0.1-2 mm |

### Expert Mode - Counter Dot Dimensions (Cone Shape)
| OpenSCAD Parameter | Web App Equivalent | Default | Range |
|---|---|---|---|
| `cone_counter_dot_base_diameter` | Cone recess base diameter | 1.9 mm | 0.5-3 mm |
| `cone_counter_dot_height` | Cone recess height | 0.7 mm | 0.3-2 mm |
| `cone_counter_dot_flat_hat` | Cone recess flat hat diameter | 1.0 mm | 0.1-2 mm |

### Rendering Quality
| OpenSCAD Parameter | Web App Equivalent | Default | Values |
|---|---|---|---|
| `render_quality` | Render Quality | `"Medium"` | `"Low"` (24 segments), `"Medium"` (32 segments), `"High"` (64 segments) |
| `cone_segments` | Cone Segments | 16 | 8-64 |

## Key Features Implemented

### 1. **Unified Shape Selection**
- `dot_shape` parameter (Customizer dropdown) controls both emboss and
  counter plate dot shapes
- When set to `"Rounded"`: Uses rounded dome dots for emboss, bowl
  recesses for counter
- When set to `"Cone"`: Uses cone frustum dots for emboss, cone recesses
  for counter

> **Backward compatibility:** the test harness and older configs may
> still set `combined_shape` (lowercase: `"rounded"` / `"cone"`). It
> lives in the `[Hidden]` block of the SCAD file and is normalized into
> `dot_shape` at load time. New code should always use `dot_shape`.

### 2. **Indicator Shapes (cylinder-only)**
- `indicator_on` (Customizer toggle, On/Off) controls whether start
  alignment markers are rendered.
- When **On**, two cells per row are reserved at the leading edge of the
  cylinder, so usable text capacity drops from `grid_columns` to
  `grid_columns - 2`:
  - **Column 0:** Triangle (orientation marker)
  - **Column 1:** Rectangle (alignment / "this side up" marker)
  - On the **counter plate**, the triangle is rotated 180° to mate with
    the emboss plate; the rectangle is rendered identically.
- When **Off**, all `grid_columns` cells are available for braille text
  and no indicator geometry is generated.

> Card indicators (rectangle at column 0, triangle at column N-1) were
> removed when card support was retired in v2.0. Only the cylinder
> layout above ships now.

### 3. **Flexible Counter Plate Recesses**
- **Bowl Recess (Rounded)**: Spherical cap with adjustable diameter and depth
- **Cone Recess (Cone)**: Frustum cone matching emboss dot shape
- Universal counter plates work for all possible dot positions

### 4. **Multiple Dot Shapes**
- **Rounded**: Cone base + hemispherical dome (more comfortable to touch)
- **Cone**: Frustum cone (traditional, easier to print)

### 5. **Cylinder Support**
- Full parametric control over diameter, height, and polygonal cutout
- Seam offset allows rotation adjustment
- Supports both rounded and cone dot shapes on curved surfaces

## Default Values Alignment

All default values match the web-based generator's defaults (0.4mm paper preset applied on load):
- Cylinder: 30.8mm diameter × 52mm height
- Grid: 11 text cells × 4 rows (with indicator shapes ON, 2 additional cells are reserved = 13 total)
- Spacing matches BANA specifications
- Default shape: Cone (project-local override; upstream defaults to Rounded — see parent `README.md` → "Project-local modifications")
- Default preset: 0.4mm (optimized for thicker paper, larger dots)

## Workflow Comparison

### Web App Workflow:
1. Enter English text
2. Select language/grade
3. Choose shape and plate type
4. Adjust expert parameters (optional)
5. Generate STL
6. Download

### OpenSCAD Workflow:
1. Translate text at https://www.branah.com/braille-translator
2. Copy Unicode braille output
3. Open OpenSCAD file
4. Paste braille into Line_1, Line_2, etc.
5. Choose `dot_shape` and `plate_type` in Customizer
6. Adjust expert parameters (optional)
7. Render (F6)
8. Export STL (File → Export → Export as STL)

## Advantages of Each Version

### Web App Advantages:
- ✅ Automatic braille translation (Liblouis)
- ✅ Live 3D preview in browser
- ✅ No software installation required
- ✅ Auto-placement mode (word wrapping)
- ✅ Multi-language support (100+ braille tables)

### OpenSCAD Advantages:
- ✅ Works offline (after text translation)
- ✅ Full parametric control in native CAD environment
- ✅ Can modify and extend code
- ✅ Integration with existing OpenSCAD workflows
- ✅ Version control friendly (plain text .scad files)
- ✅ Batch processing possible via command line

## Notes

1. **Paper Thickness Preset System**: This is a convenience system that sets 23 parameters to known-good values:
   - **0.4mm preset** (thicker paper, larger dots): Default setting that matches web app on-load behavior
   - **0.3mm preset** (thinner paper, smaller dots): Alternative optimized for thinner materials
   - **Custom**: Indicator state when values deviate from presets
   - The preset controls: spacing (7 params), emboss rounded (4 params), emboss cone (3 params), counter bowl (2 params), counter cone (3 params), and cylinder dimensions (5 params)
   - Text, plate type, shape selection, and rendering quality remain user-controlled

2. **Indicator Shapes**: When enabled (`indicator_on = true` in the
   Customizer; `indicator_shapes = "on"` is the legacy backward-compat
   alias), the cylinder reserves the **first two cells** (col 0 = triangle,
   col 1 = rectangle) at the leading edge for alignment markers. The
   `grid_columns` parameter represents the number of cells *available for
   text*, not including indicators - the code internally adds 2 cells when
   indicators are on.

3. **Rounded vs. Cone**: The web app calls these "Rounded" and "Cone" - both terms refer to the combined emboss+counter shape pair.

4. **Counter Plate Universality**: Counter plates have recesses at ALL possible dot positions (all 6 dots × all cells × all rows), making them universal for any braille pattern.

5. **Parameter Names**: OpenSCAD uses snake_case (e.g., `grid_columns`) to match the web app's JavaScript variable names, ensuring consistency across platforms.

6. **"Card Thickness" UI Label**: Despite the web UI label "Card Thickness", this preset system is NOT the removed card-geometry feature. It's a parametric memory system for setting multiple dials at once.

## References

- Web-based Generator: https://braille-card-and-cylinder-stl-gener.vercel.app
- Web App Source: https://github.com/BrennenJohnston/braille-card-and-cylinder-stl-generator
- OpenSCAD Version: https://github.com/BrennenJohnston/braille-stl-generator-openscad
- Branah Braille Translator: https://www.branah.com/braille-translator
- BANA Size & Spacing: https://brailleauthority.org/size-and-spacing-braille-characters
