BrennenJohnston/custom-braille-embosser-3d-printing-project/Photos/Gif/Custom_Braille_Embosser_3d_Printing_Step3_1.gif

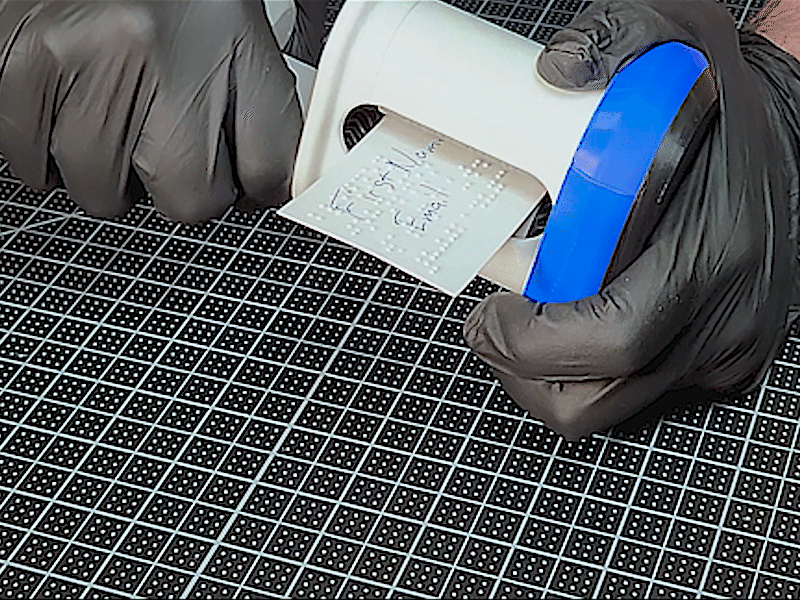
Photos/Gif/Custom_Braille_Embosser_3d_Printing_Step3_1.gif
