BrennenJohnston/custom-braille-embosser-3d-printing-project/Settings Research/Braille Embosser Assembly v1.0/BEAp11.png

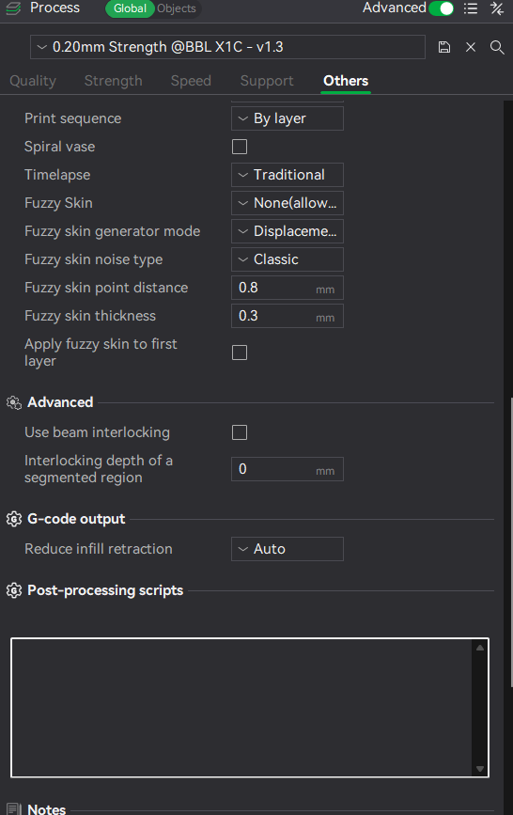
Settings Research/Braille Embosser Assembly v1.0/BEAp11.png
