BrennenJohnston/custom-braille-embosser-3d-printing-project/Video_Tutorials/Video_1_Customizing_Braille_Downloading_STL_3D_Print_Settings/Braille STL Generator.png

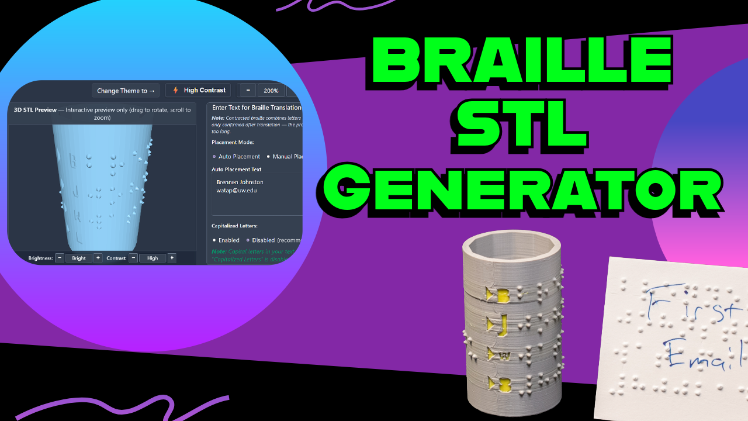
Video_Tutorials/Video_1_Customizing_Braille_Downloading_STL_3D_Print_Settings/Braille STL Generator.png
