BrennenJohnston/custom-braille-embosser-3d-printing-project/Video_Tutorials/Video_1_Customizing_Braille_Downloading_STL_3D_Print_Settings/Thumb1.png

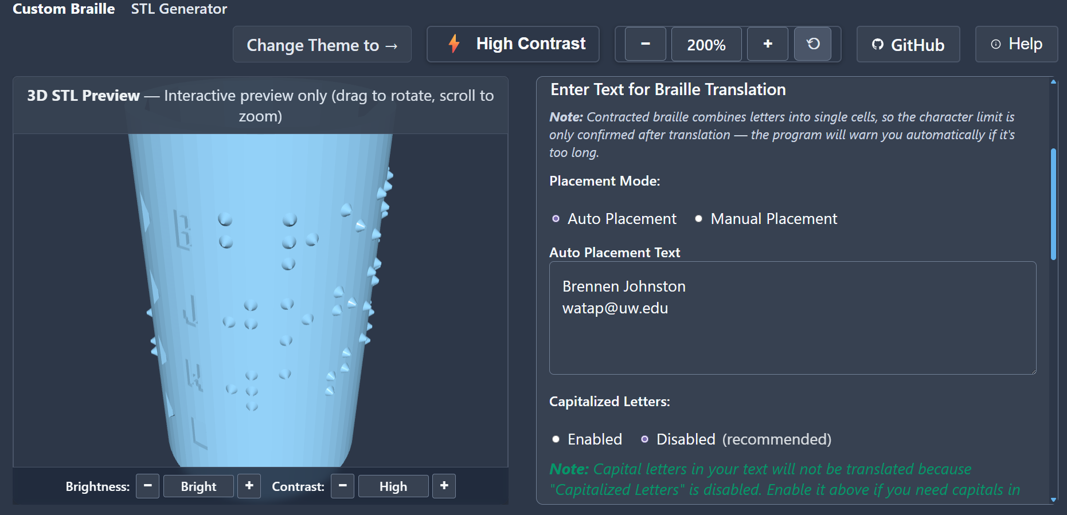
Video_Tutorials/Video_1_Customizing_Braille_Downloading_STL_3D_Print_Settings/Thumb1.png
