BrennenJohnston/custom-braille-embosser-3d-printing-project/Video_Tutorials/Video_2_Assembling_Braille_Embosser_3D_Printed_Parts/Braille Embosser Assembly.png

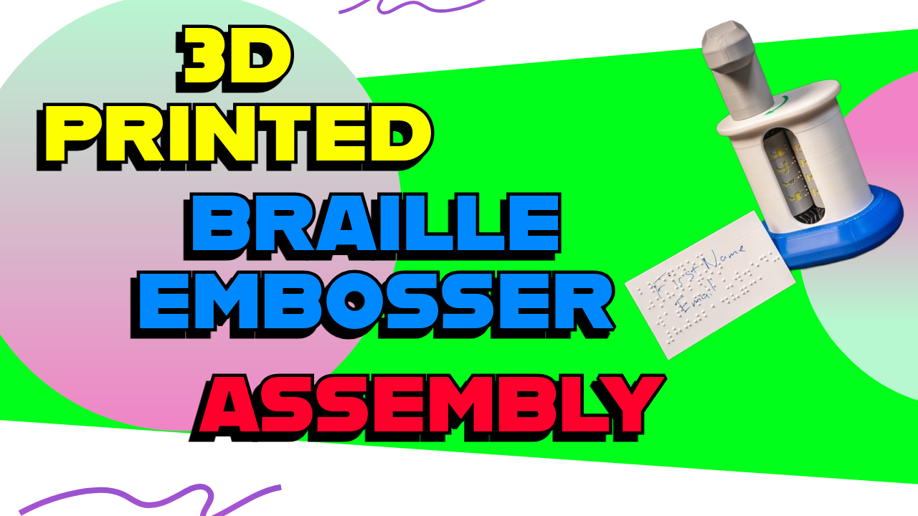
Video_Tutorials/Video_2_Assembling_Braille_Embosser_3D_Printed_Parts/Braille Embosser Assembly.png
