BrennenJohnston/custom-braille-embosser-3d-printing-project/Video_Tutorials/Video_2_Screen_Shots/1/P03-P04-P_A.jpg

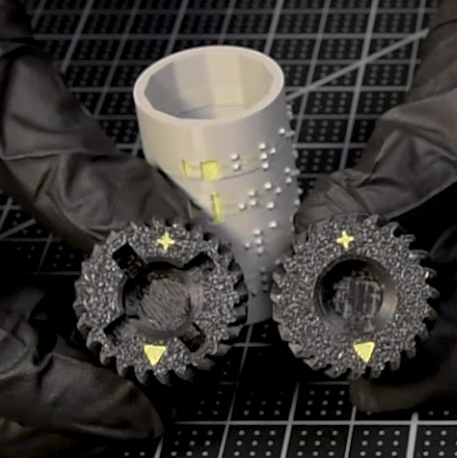
Video_Tutorials/Video_2_Screen_Shots/1/P03-P04-P_A.jpg
