BrennenJohnston/custom-braille-embosser-3d-printing-project/Video_Tutorials/Video_2_Screen_Shots/1/P05-P06-P_B.jpg

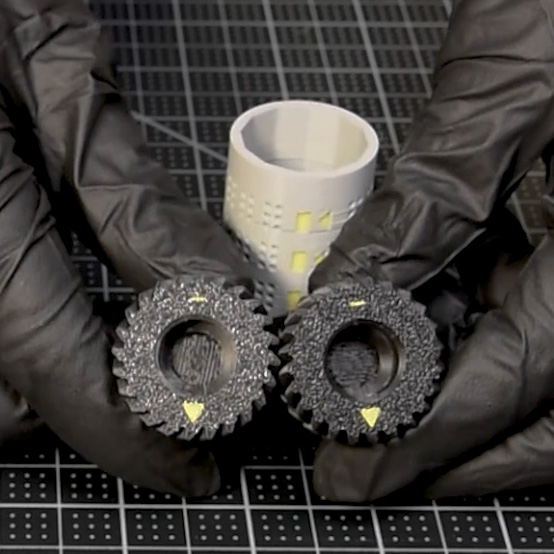
Video_Tutorials/Video_2_Screen_Shots/1/P05-P06-P_B.jpg
