BrennenJohnston/custom-braille-embosser-3d-printing-project/Video_Tutorials/Video_2_Screen_Shots/1/P_B-Counter Cylinder.jpg

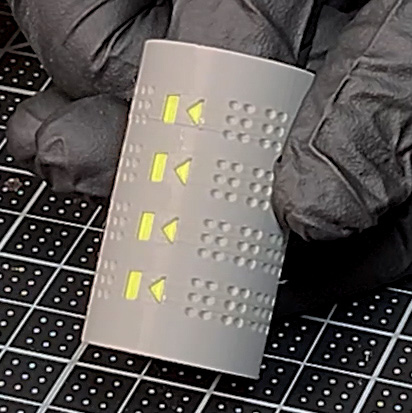
Video_Tutorials/Video_2_Screen_Shots/1/P_B-Counter Cylinder.jpg
