BrennenJohnston/custom-braille-embosser-3d-printing-project/Video_Tutorials/Video_2_Screen_Shots/2/P03-P04.jpg

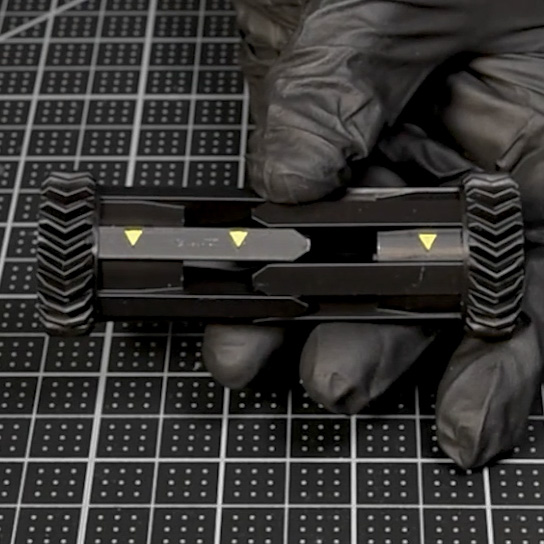
Video_Tutorials/Video_2_Screen_Shots/2/P03-P04.jpg
