BrennenJohnston/custom-braille-embosser-3d-printing-project/Video_Tutorials/Video_2_Screen_Shots/3/P03-P_A-P04_P05-P_B-P06.jpg

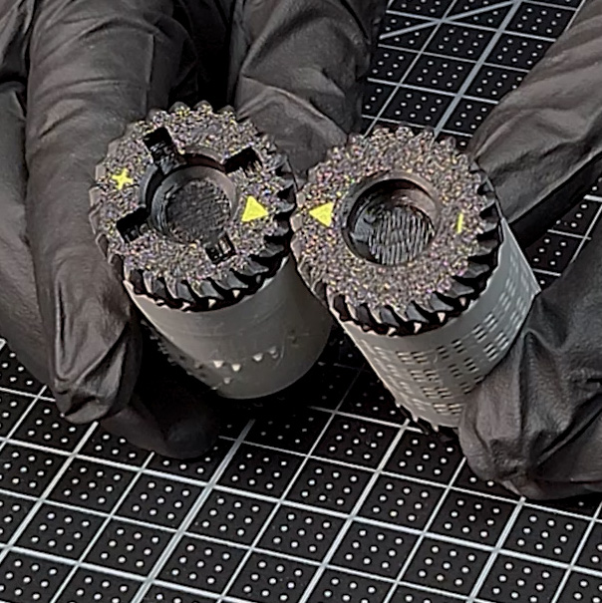
Video_Tutorials/Video_2_Screen_Shots/3/P03-P_A-P04_P05-P_B-P06.jpg
