BrennenJohnston/custom-braille-embosser-3d-printing-project/Video_Tutorials/Video_2_Screen_Shots/4/P08_P07.jpg

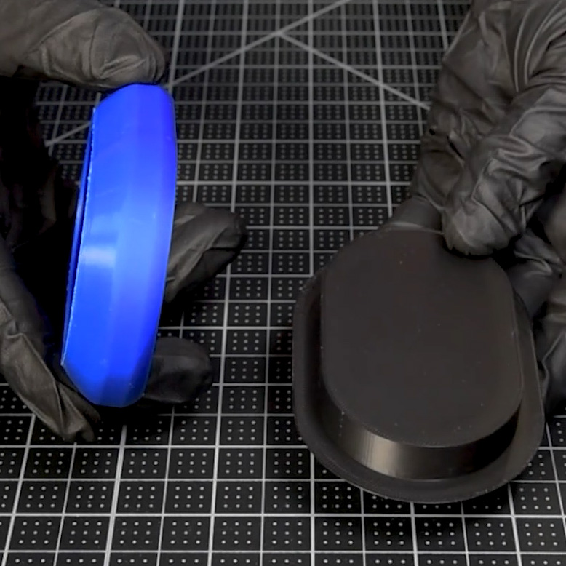
Video_Tutorials/Video_2_Screen_Shots/4/P08_P07.jpg
