BrennenJohnston/custom-braille-embosser-3d-printing-project/Video_Tutorials/Video_2_Screen_Shots/5/P01-P02-P07-P08_Completed.jpg

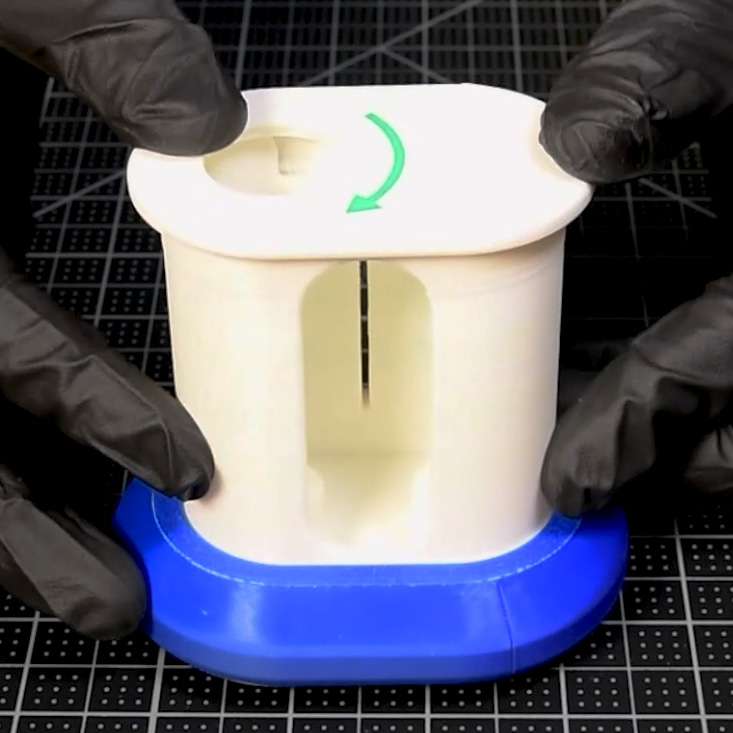
Video_Tutorials/Video_2_Screen_Shots/5/P01-P02-P07-P08_Completed.jpg
