BrennenJohnston/custom-braille-embosser-3d-printing-project/Video_Tutorials/Video_2_Screen_Shots/6/P03-P_A-P04-P05-P_B-P06-P01-continued.jpg

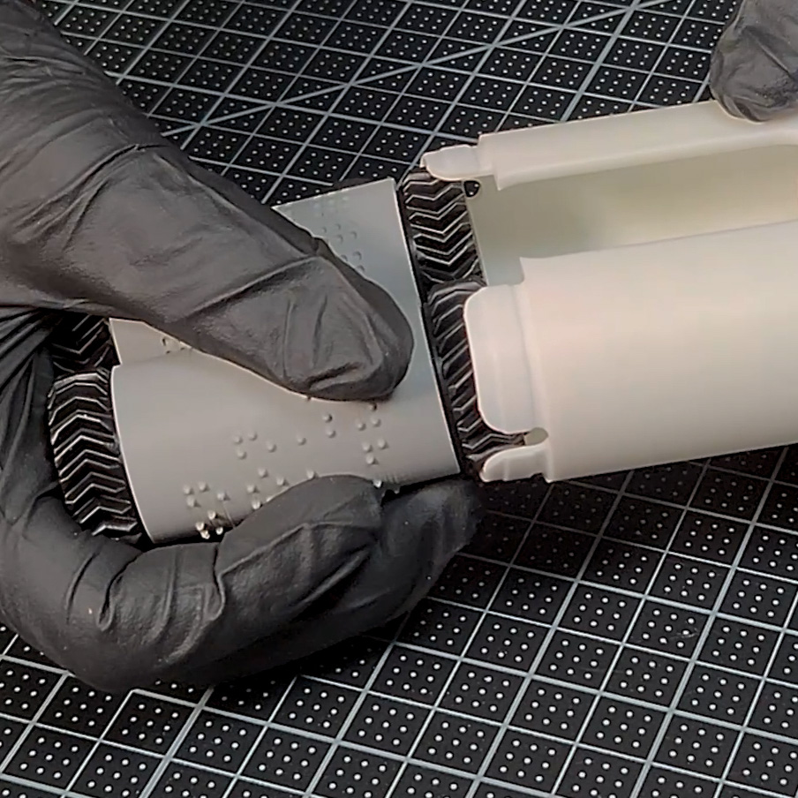
Video_Tutorials/Video_2_Screen_Shots/6/P03-P_A-P04-P05-P_B-P06-P01-continued.jpg
