BrennenJohnston/custom-braille-embosser-3d-printing-project/Video_Tutorials/Video_2_Screen_Shots/9/P02-P09-P03-P_A-P04-P05-P_B-P06-P01-P07-P08-P10.jpg

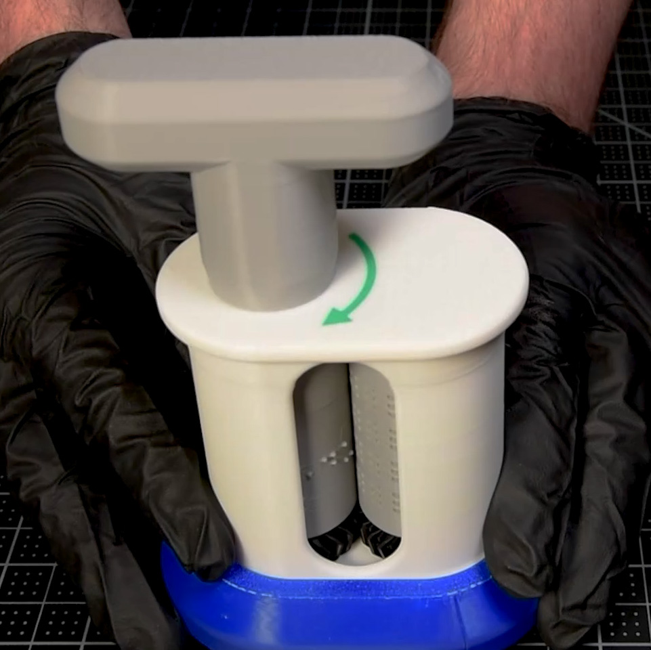
Video_Tutorials/Video_2_Screen_Shots/9/P02-P09-P03-P_A-P04-P05-P_B-P06-P01-P07-P08-P10.jpg
