BrennenJohnston/custom-braille-embosser-3d-printing-project/Video_Tutorials/Video_3_How_To_Use_Completed_Braille_Embosser/How To Use Braille Embosser (1).png

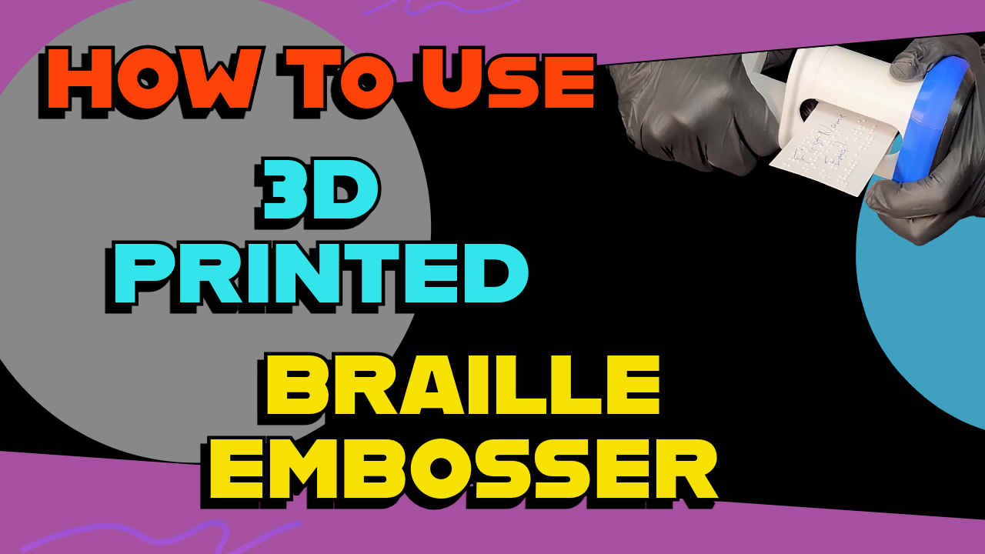
Video_Tutorials/Video_3_How_To_Use_Completed_Braille_Embosser/How To Use Braille Embosser (1).png
