BrennenJohnston/custom-braille-embosser-3d-printing-project/Design_Files/Blue Prints/Body v1.0 (0.pdf

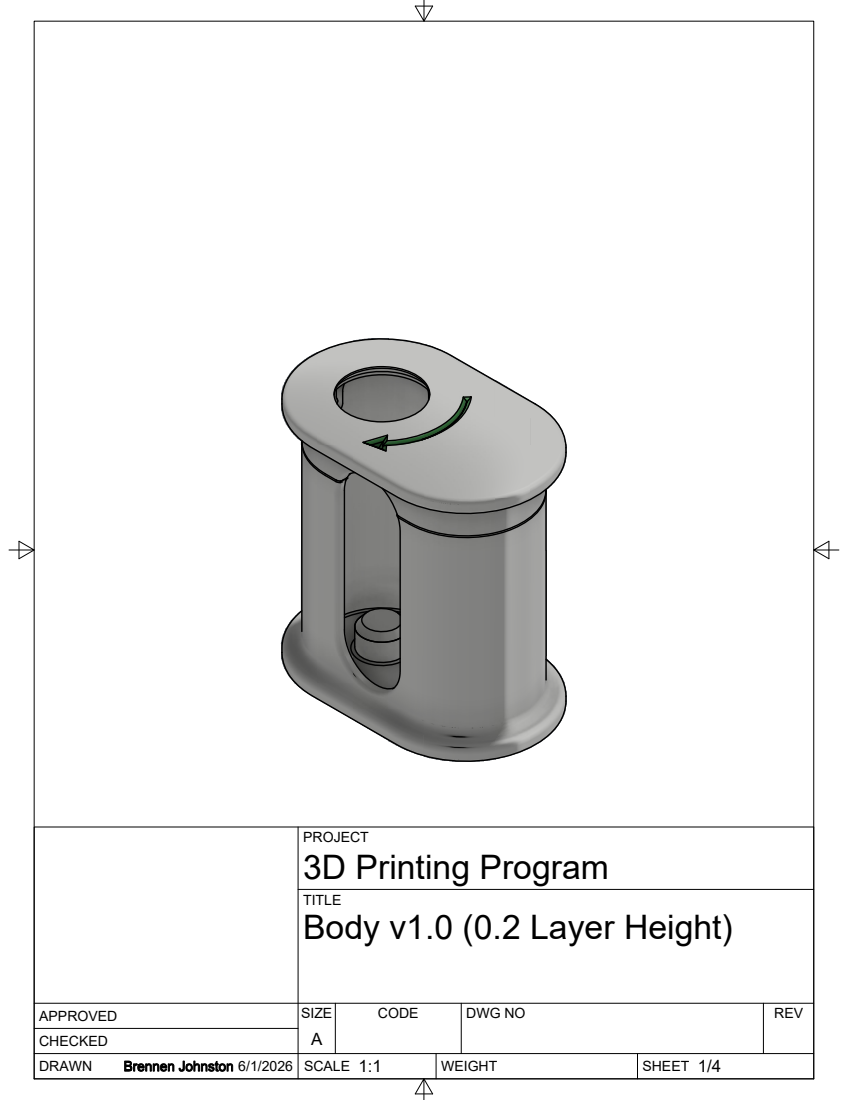
[picture p88: page 1]
TITLE; DRAWN; CHECKED; APPROVED; SCALE; WEIGHT; SHEET; SIZE; CODE; DWG NO; REV

PROJECT
3D Printing Program
Body v1.0 (0.2 Layer Height)
