BrennenJohnston/custom-braille-embosser-3d-printing-project/Design_Files/Blue Prints/Cylinder Roller Holder v1.0 (0.pdf

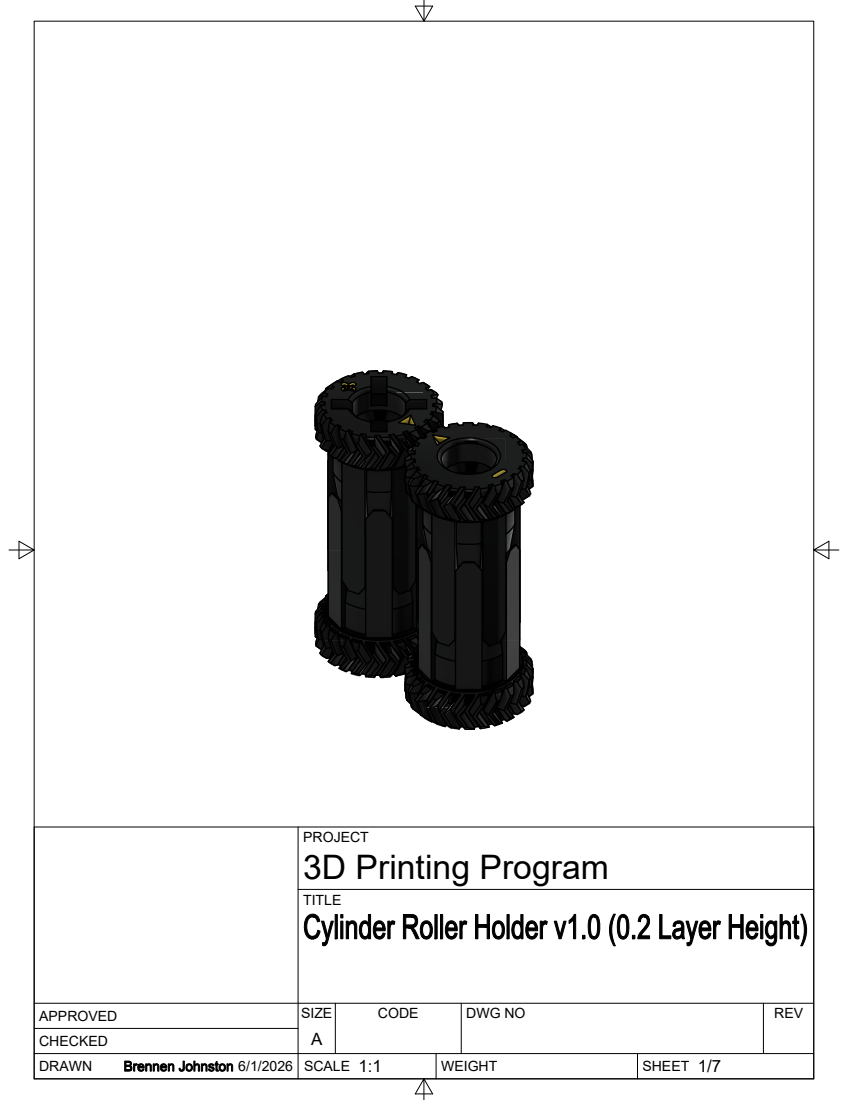
[picture p89: page 1]
PROJECT; TITLE; DRAWN; CHECKED; APPROVED; SCALE; WEIGHT; SHEET; SIZE; CODE; DWG NO; REV; 3D Printing Program
